rehsd/PC-65816/README.md

# PC-65816
PC based on 65816 microprocessor, now running at 14 MHz

Repository for schematics, PCB designs, assembly code, etc. for 65816-based motherboard and related peripherals. All schematic/PCB archives are from EasyEDA.

https://www.rehsdonline.com/blog/categories/65816-1
