rehsd/PC-65816/Schematics and PCB Design Files/Motherboard 1.2/Address Decode PLD/Read Me.txt

*.dig (software: Digital) -- see https://github.com/hneemann/Digital

*.png -- overview of the address decode logic I am using

*.jed -- compiled file to be burned to PLD, based on .png and .dig above

How to: https://www.rehsdonline.com/post/using-gal22v10-programmable-logic-devices
