rehsd/PC-65816/Schematics and PCB Design Files/Motherboard 1.2/Address Decode PLD/Addressing Worksheet.png

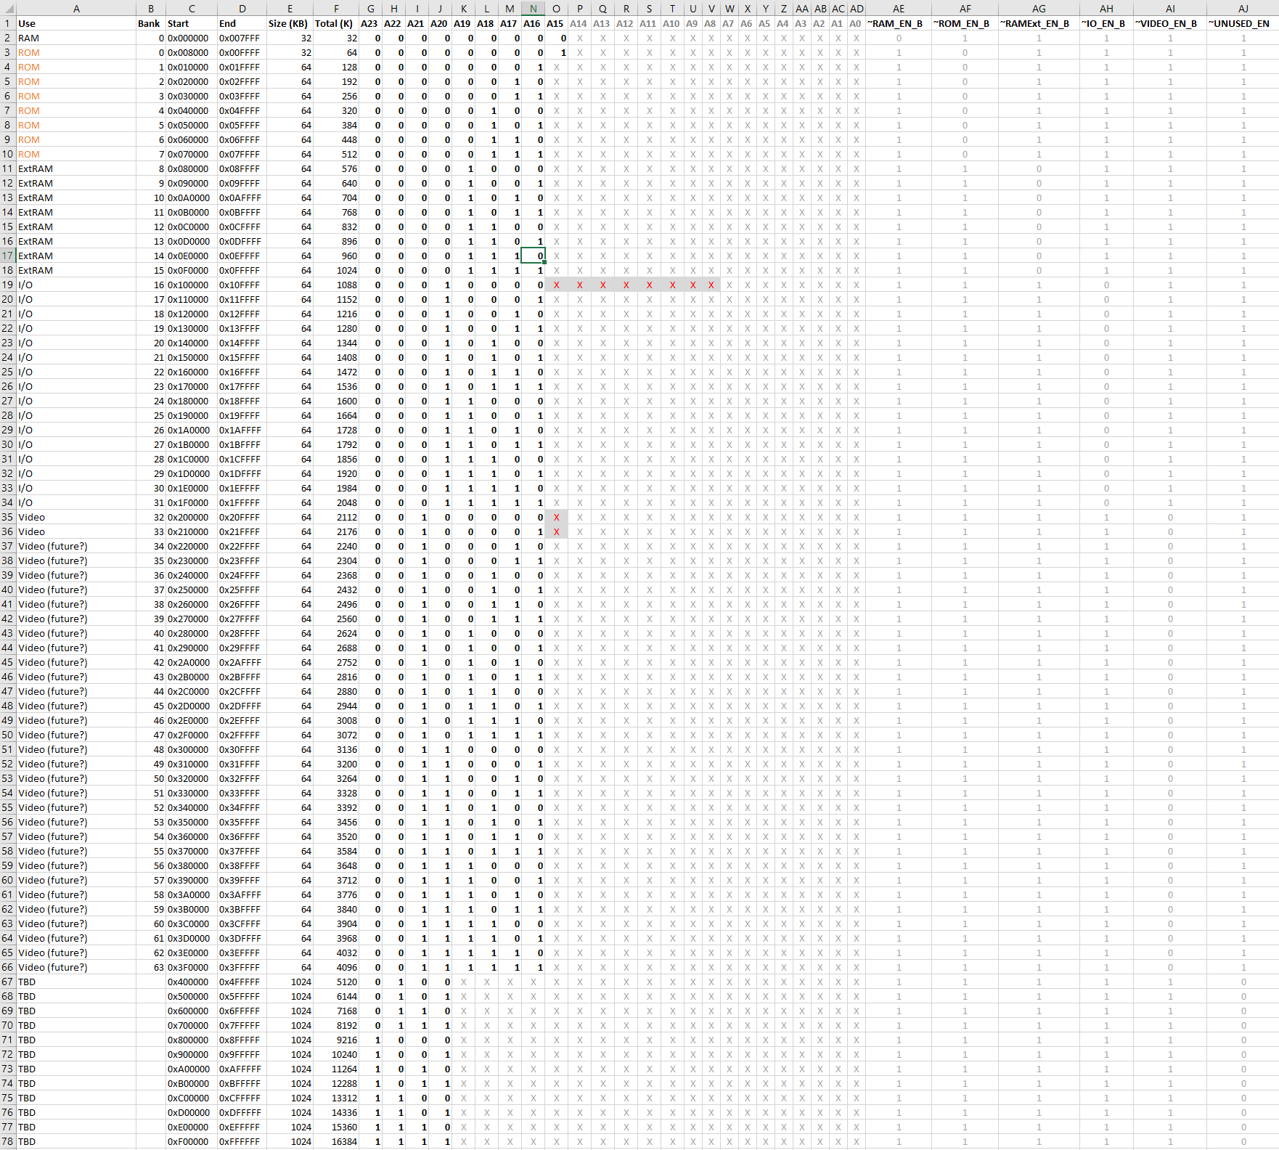
Schematics and PCB Design Files/Motherboard 1.2/Address Decode PLD/Addressing Worksheet.png
