rehsd/PC-65816/Schematics and PCB Design Files/Motherboard 1.2/Address Decode PLD/Logic in Digital.png

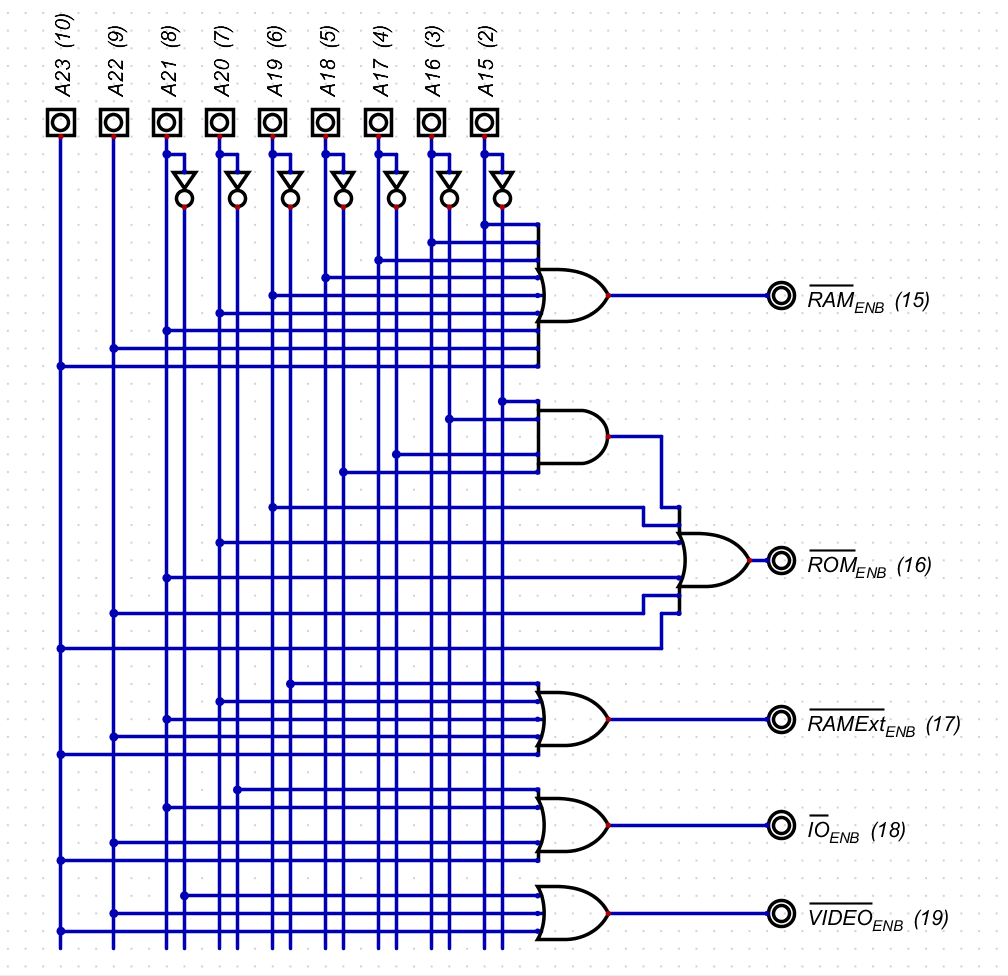
Schematics and PCB Design Files/Motherboard 1.2/Address Decode PLD/Logic in Digital.png
