rehsd/PC-65816/Schematics and PCB Design Files/Motherboard 1.2/mb 1.2 back.png

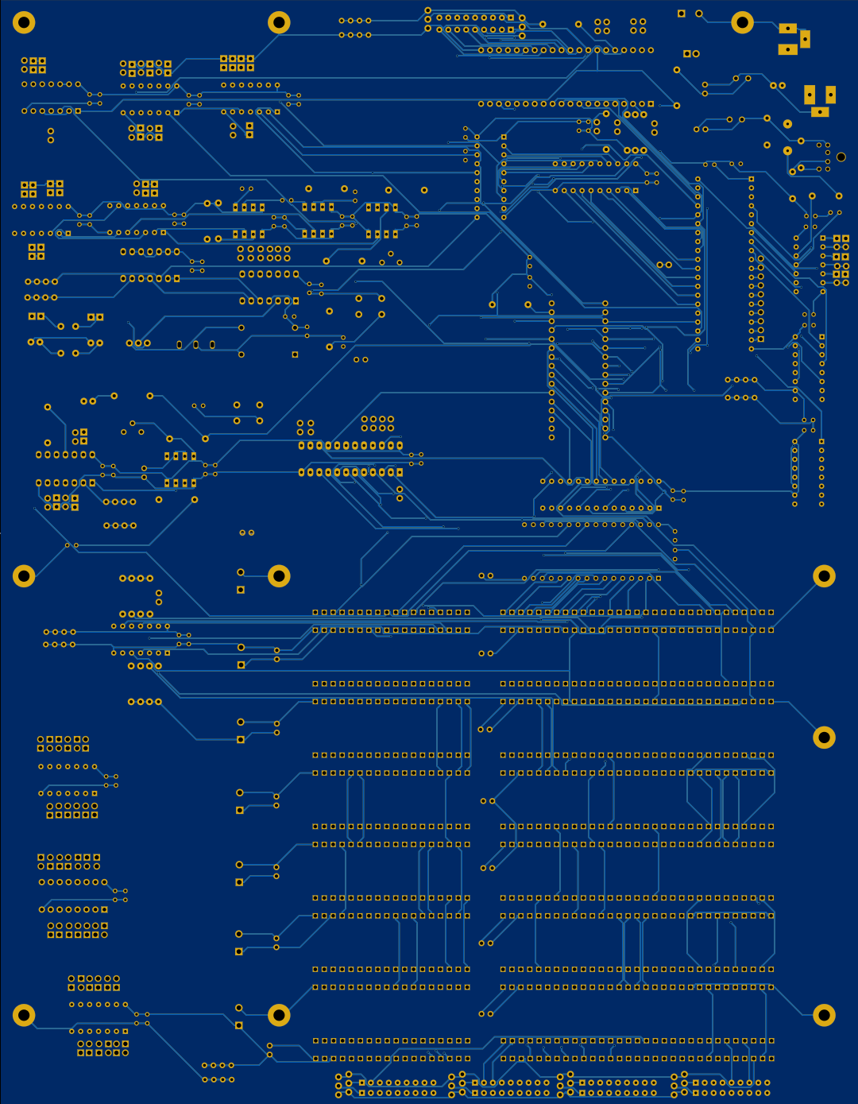
Schematics and PCB Design Files/Motherboard 1.2/mb 1.2 back.png
