rehsd/PC-65816/Schematics and PCB Design Files/Sound Card 1.1/Sound Card 65816 version 1.1 PCB.png

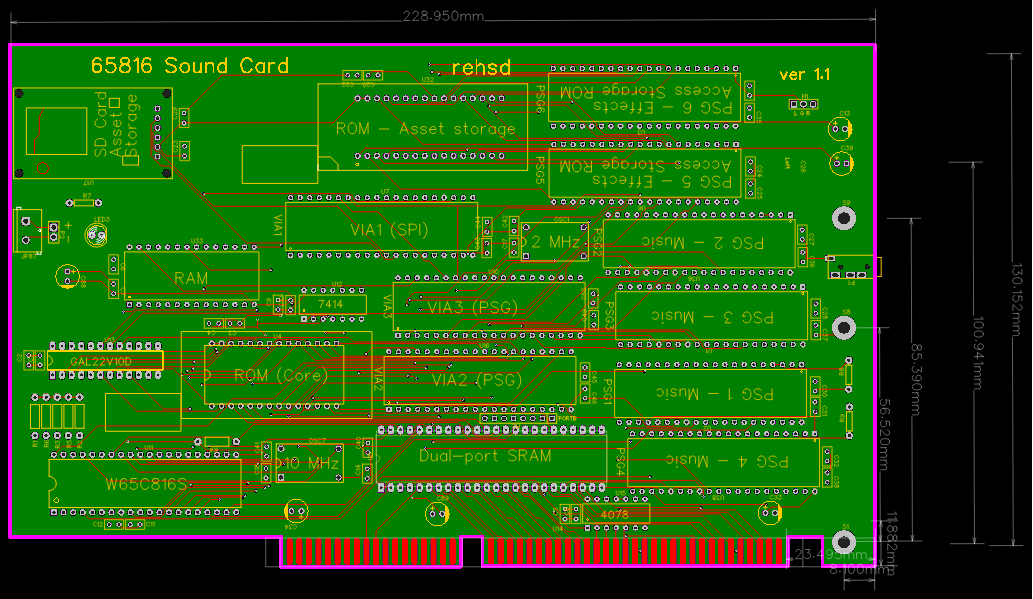
Schematics and PCB Design Files/Sound Card 1.1/Sound Card 65816 version 1.1 PCB.png
