rehsd/PC-65816/Schematics and PCB Design Files/Sound Card 1.1/Sound Card 65816 version 1.1b SCHEMATIC.pdf

# 256Kx8 RAM Audio Core

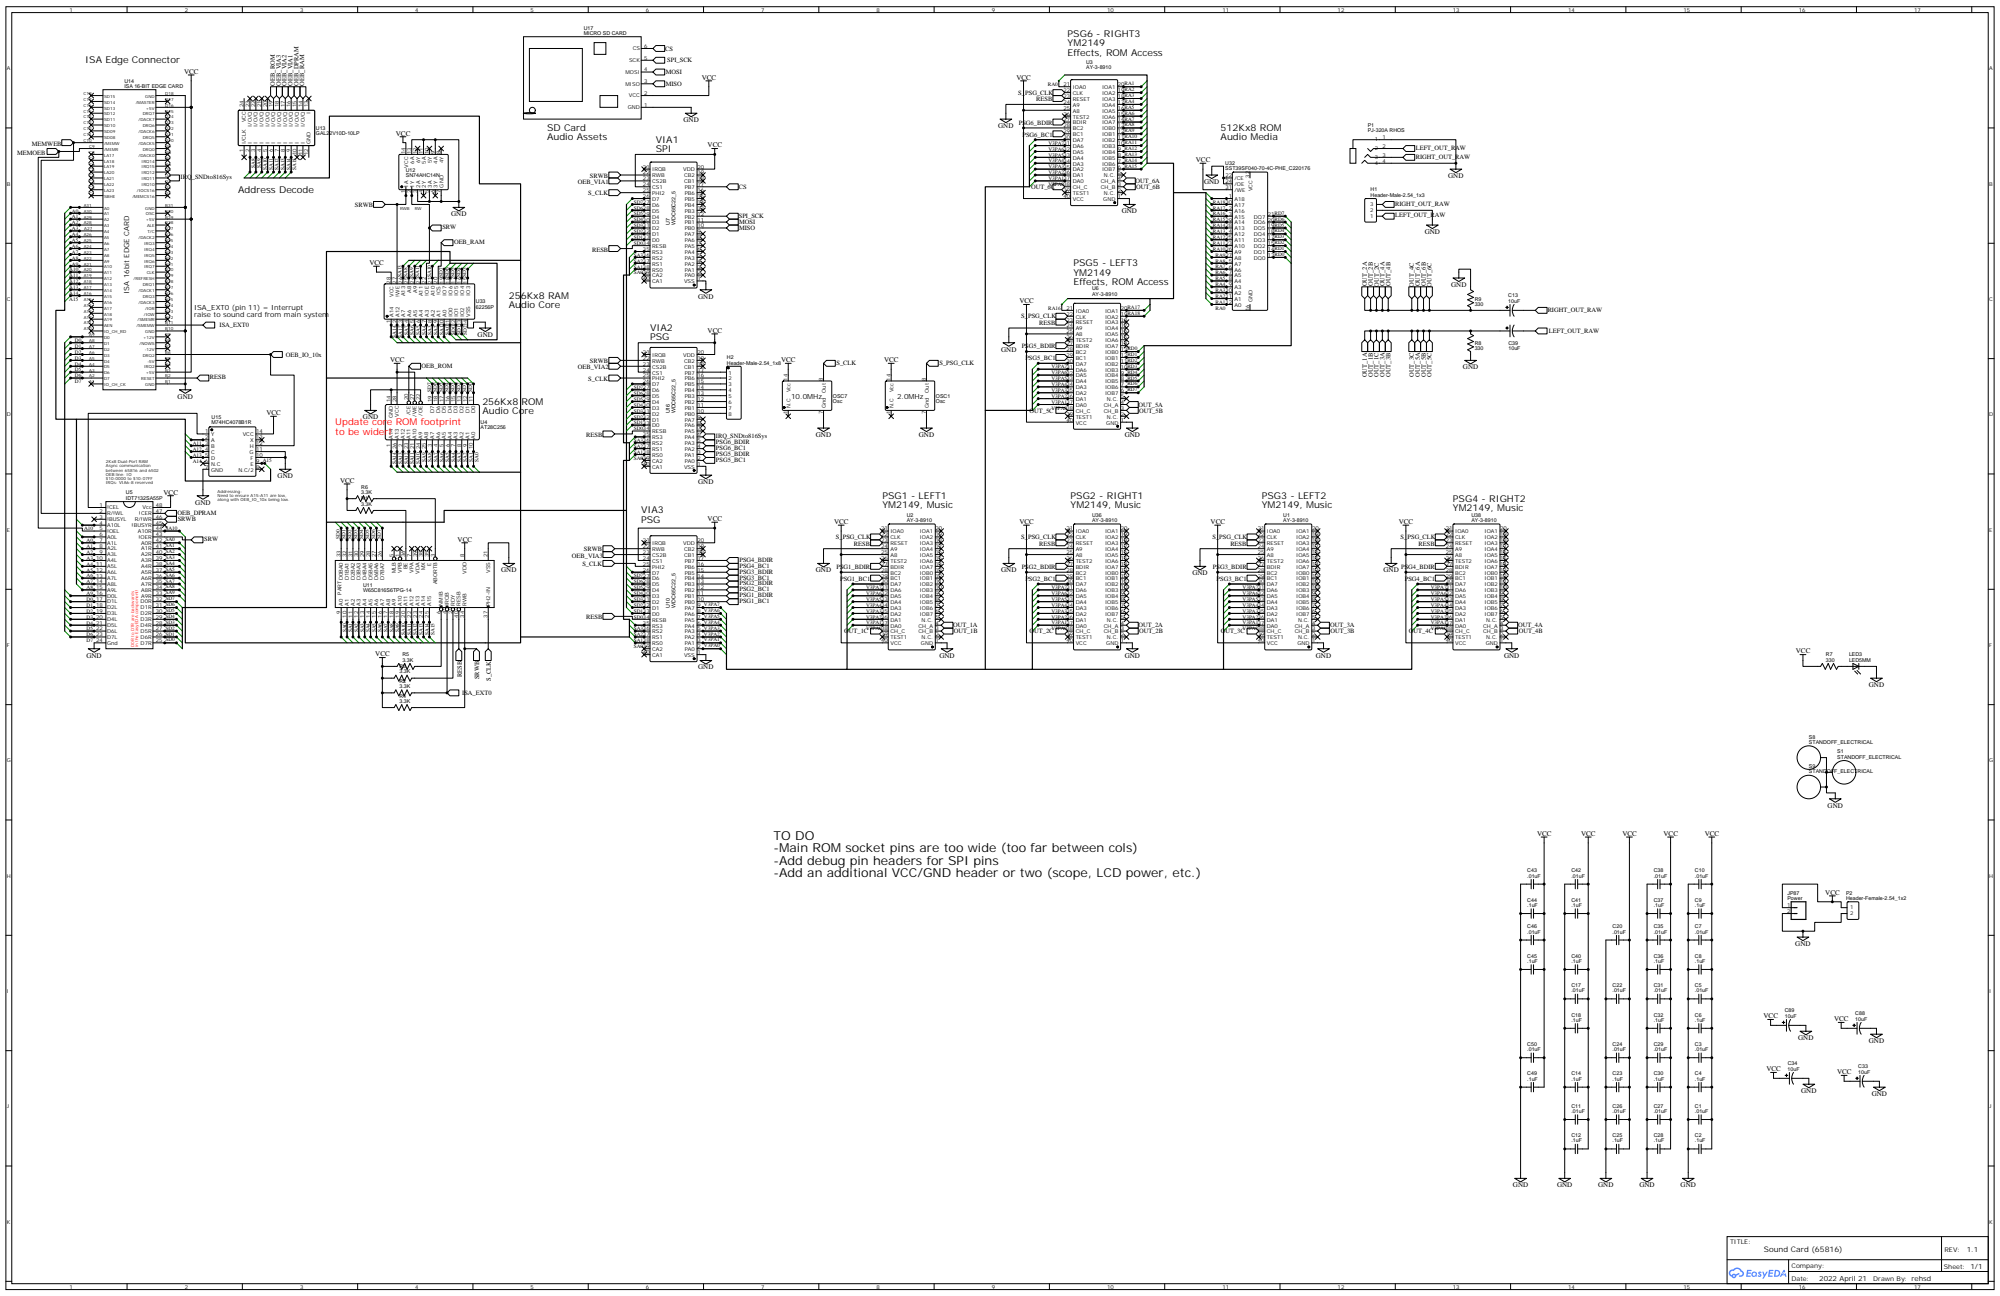
[picture p6: page 1]

ISA 16-BIT EDGE CARD

VSS 14 IO3 15 IO4 16 IO5 17 IO6 18 IO7 19 !CS 20 A10 21 !OE 22 A11 23 A9 24 A8 25 A13 26 !WE 27 VCC 28

ISA_EXT0 (pin 11) = Interrupt
raise to sound card from main system

GND
Update core ROM footprint
to be wider!

in the EasyEDA component!

-Main ROM socket pins are too wide (too far between cols)
-Add debug pin headers for SPI pins
-Add an additional VCC/GND header or two (scope, LCD power, etc.)
