rehsd/PC-65816/Schematics and PCB Design Files/Motherboard 1.2/Schematic_65816 Motherboard 1.0_2022-05-04.pdf

## RAM

32Kx8

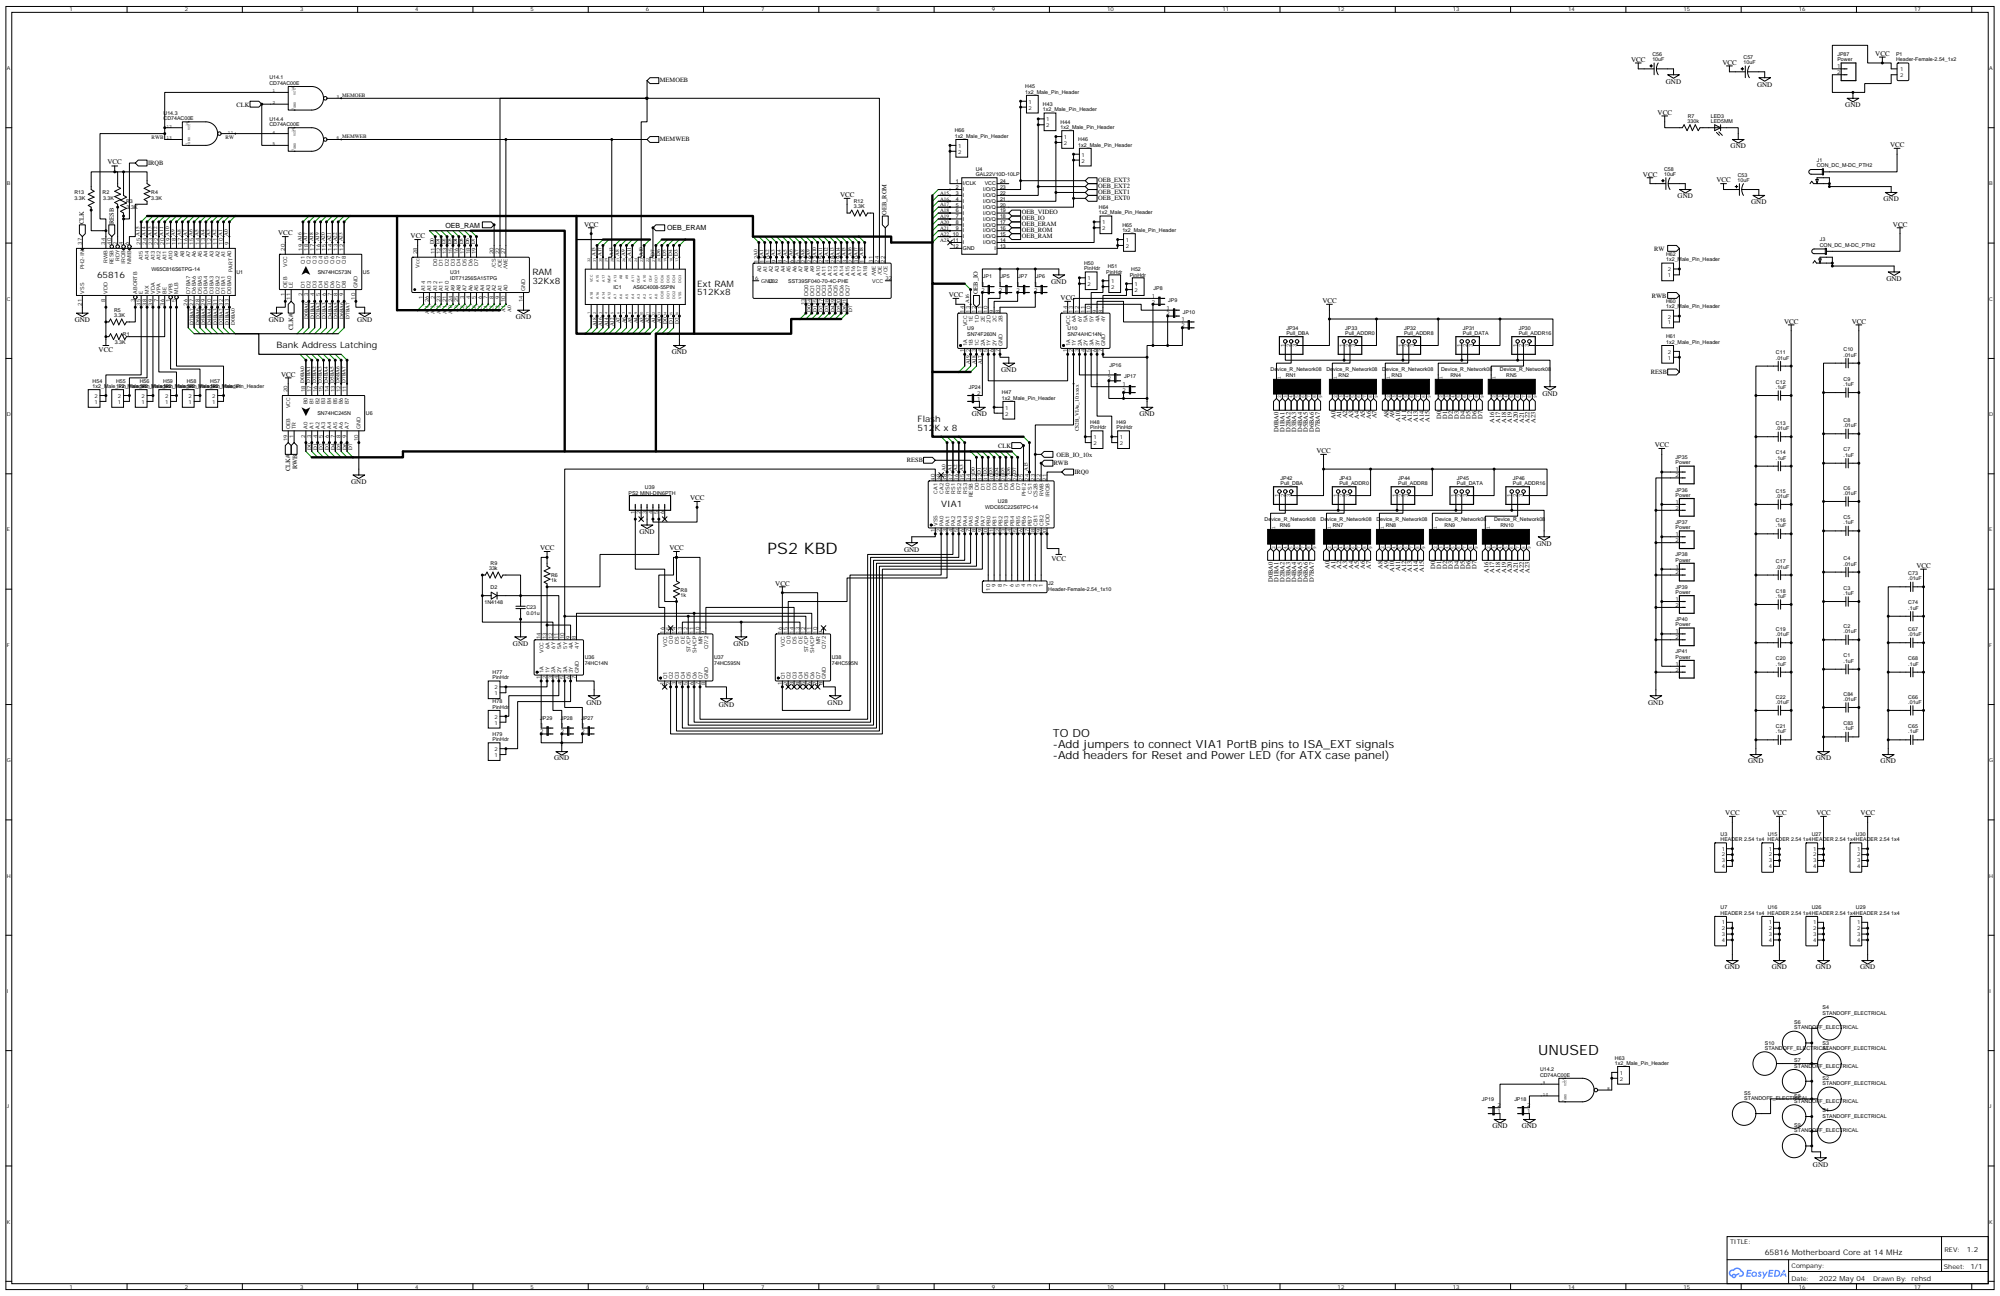
[picture p7: page 1]

VIA1 A⁰ A¹ A² A³

VDD 20 IRQB 21 RWB 22 CS2B 23 CS1 24 PHI2 25 D7 26 D6 27 D5 28 D4 29 D3 30 D2 31 D1 32 D0 33 RESB 34 RS3 35 RS2 36 RS1 37 RS0 38 CA2 39 CA1 40

9 MR 10 SH/CP 11 ST/CP 12 OE 13 DS 14 Q0 15 VCC 16

-Add jumpers to connect VIA1 PortB pins to ISA_EXT signals
-Add headers for Reset and Power LED (for ATX case panel)

65816 Motherboard Core at 14 MHz

## Reset

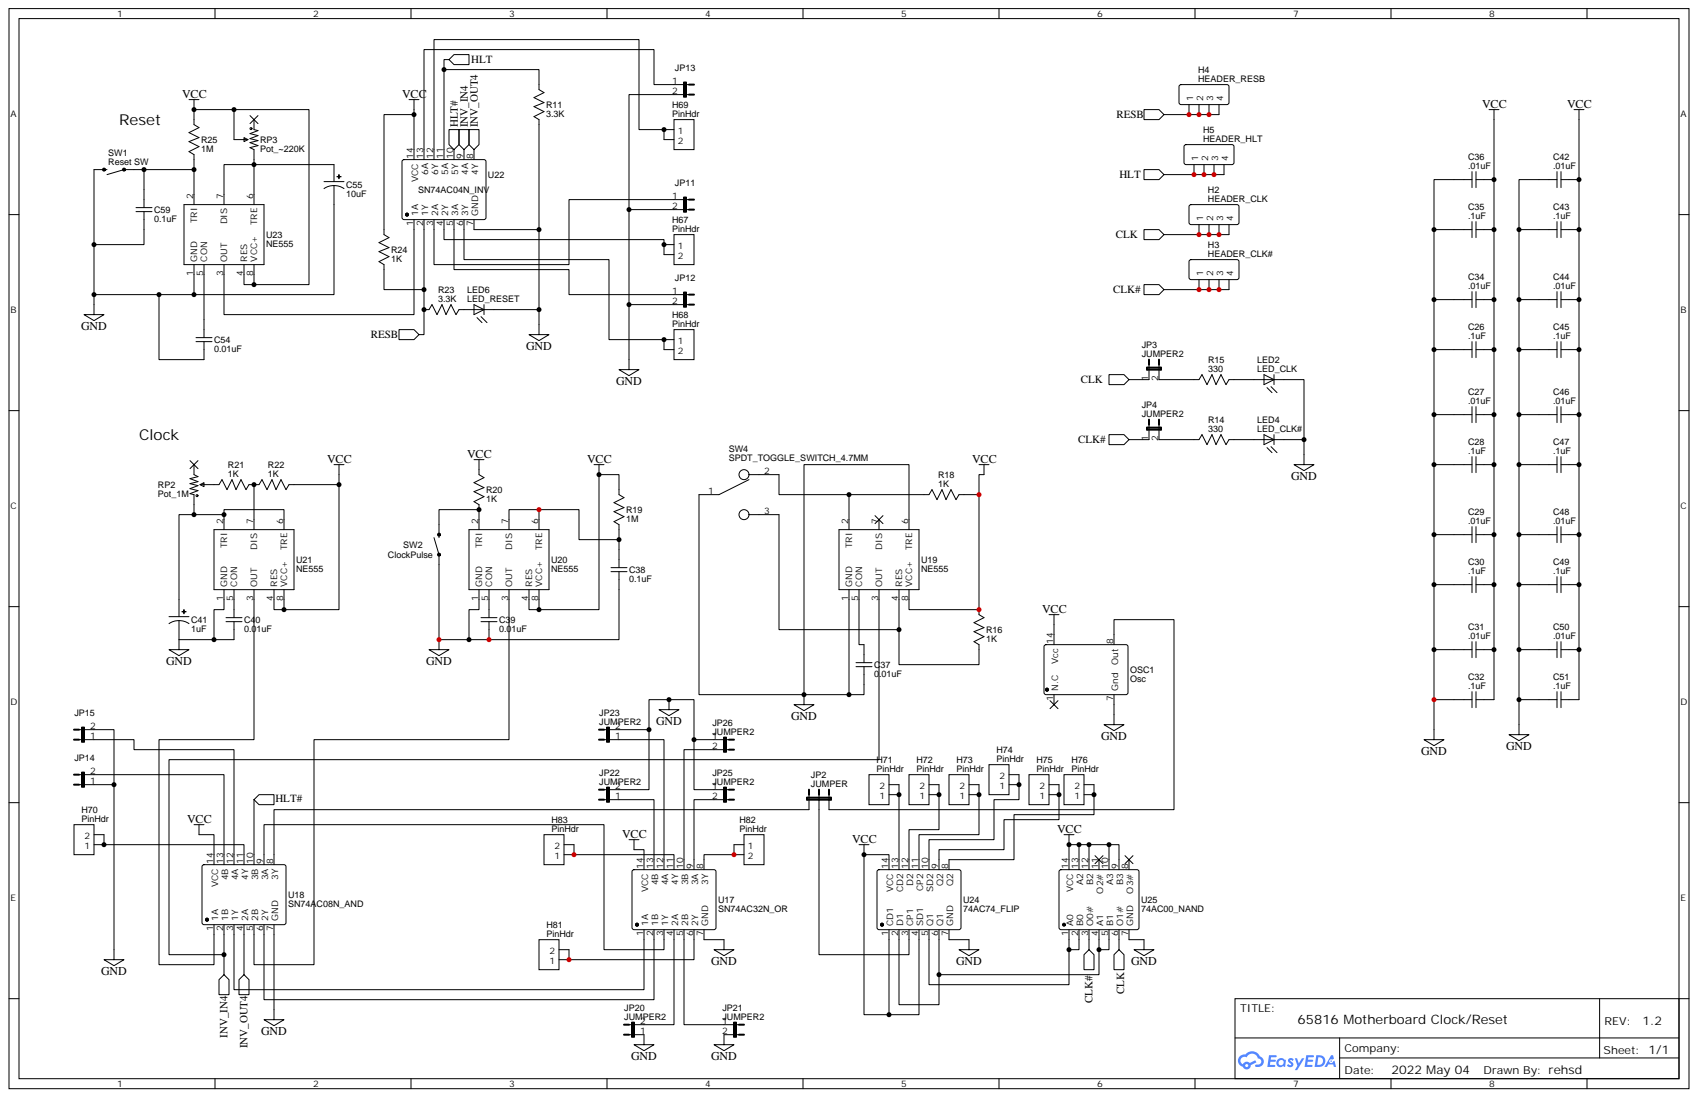
[picture p8: page 2]

GND 10 SMEMW 11 SMEMR 12 IOW 13 IOR 14 DACK3 15 DRQ3 16 DACK1 17 DRQ1 18 REFRESH 19 CLK 20 IRQ5 21 IRQ4 22 IRQ3 23 IRQ2 24 IRQ1 25 DACK2 26 TC 27 ALE 28 +5V 29 CLK# 30 GND 31
IOCHK 50 DB7 51 DB6 52 DB5 53 DB4 54 DB3 55 DB2 56 DB1 57 DB0 58 IORDY 59 AEN 60 BA19 61 BA18 62 BA17 63 BA16 64 BA15 65 BA14 66 BA13 67 BA12 68 BA11 69 BA10 70 BA9 71 BA8 72 BA7 73 BA6 74 BA5 75 BA4 76 BA3 77

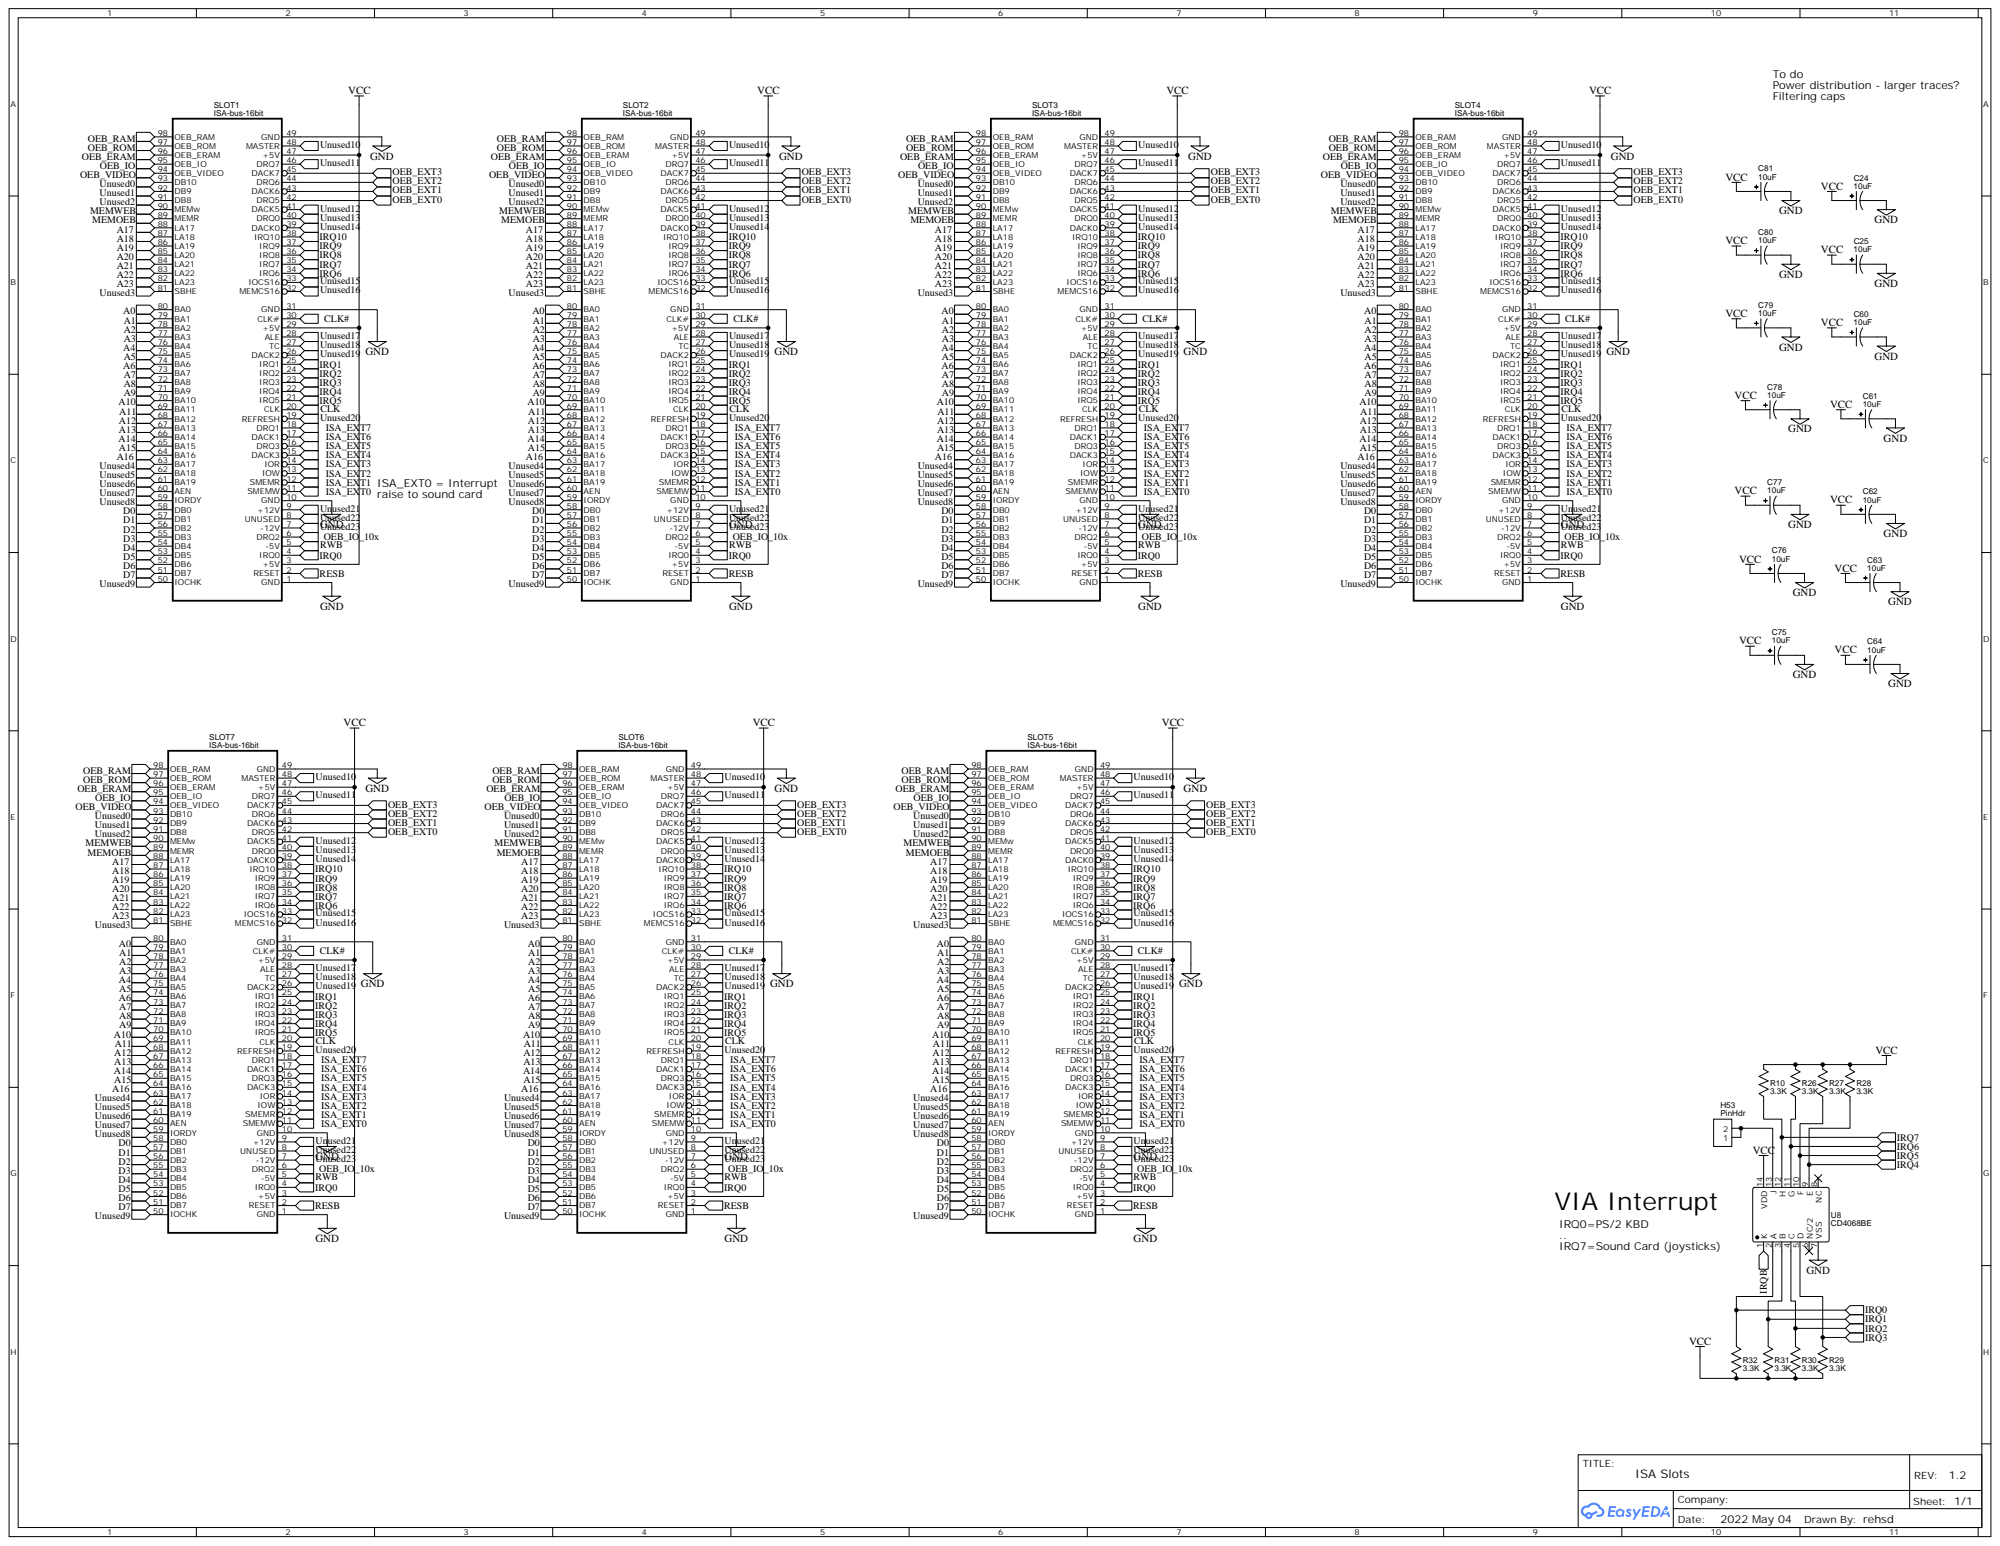
[picture p9: page 3]

Power distribution - larger traces?
Filtering caps

ISA_EXT0 = Interrupt
raise to sound card

## General Logic ICs

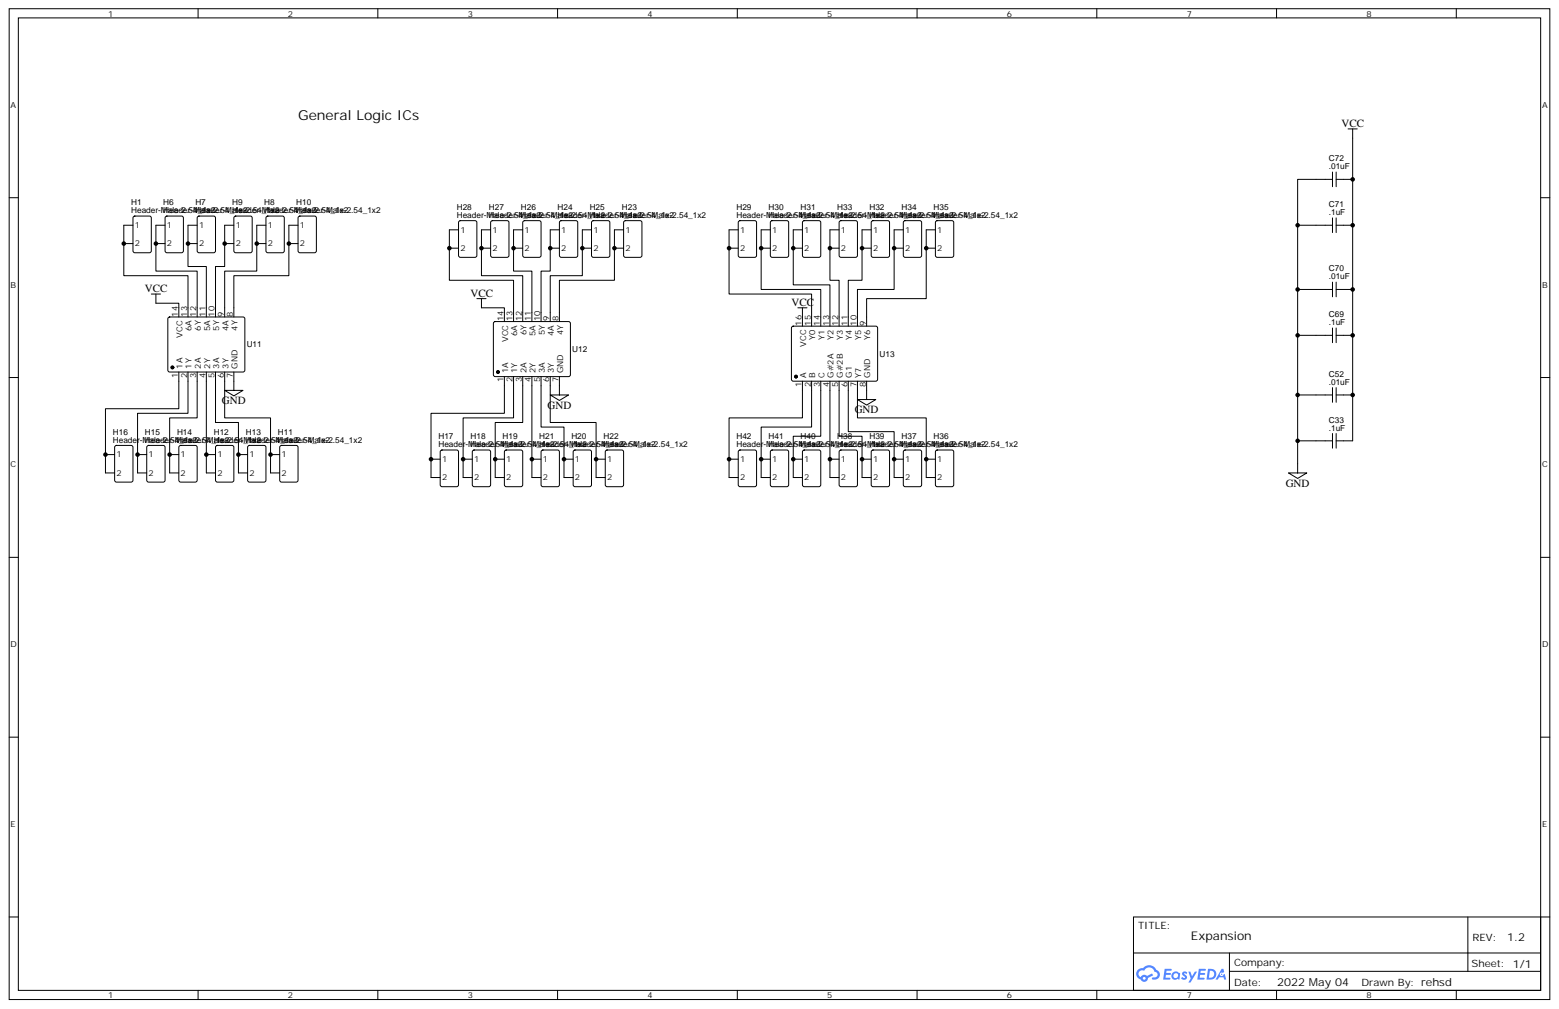
[picture p10: page 4]
