rehsd/PC-65816/Schematics and PCB Design Files/Updated Designs/Schematic_65816 ISA LCD_2022-04-19.pdf

A | A

1

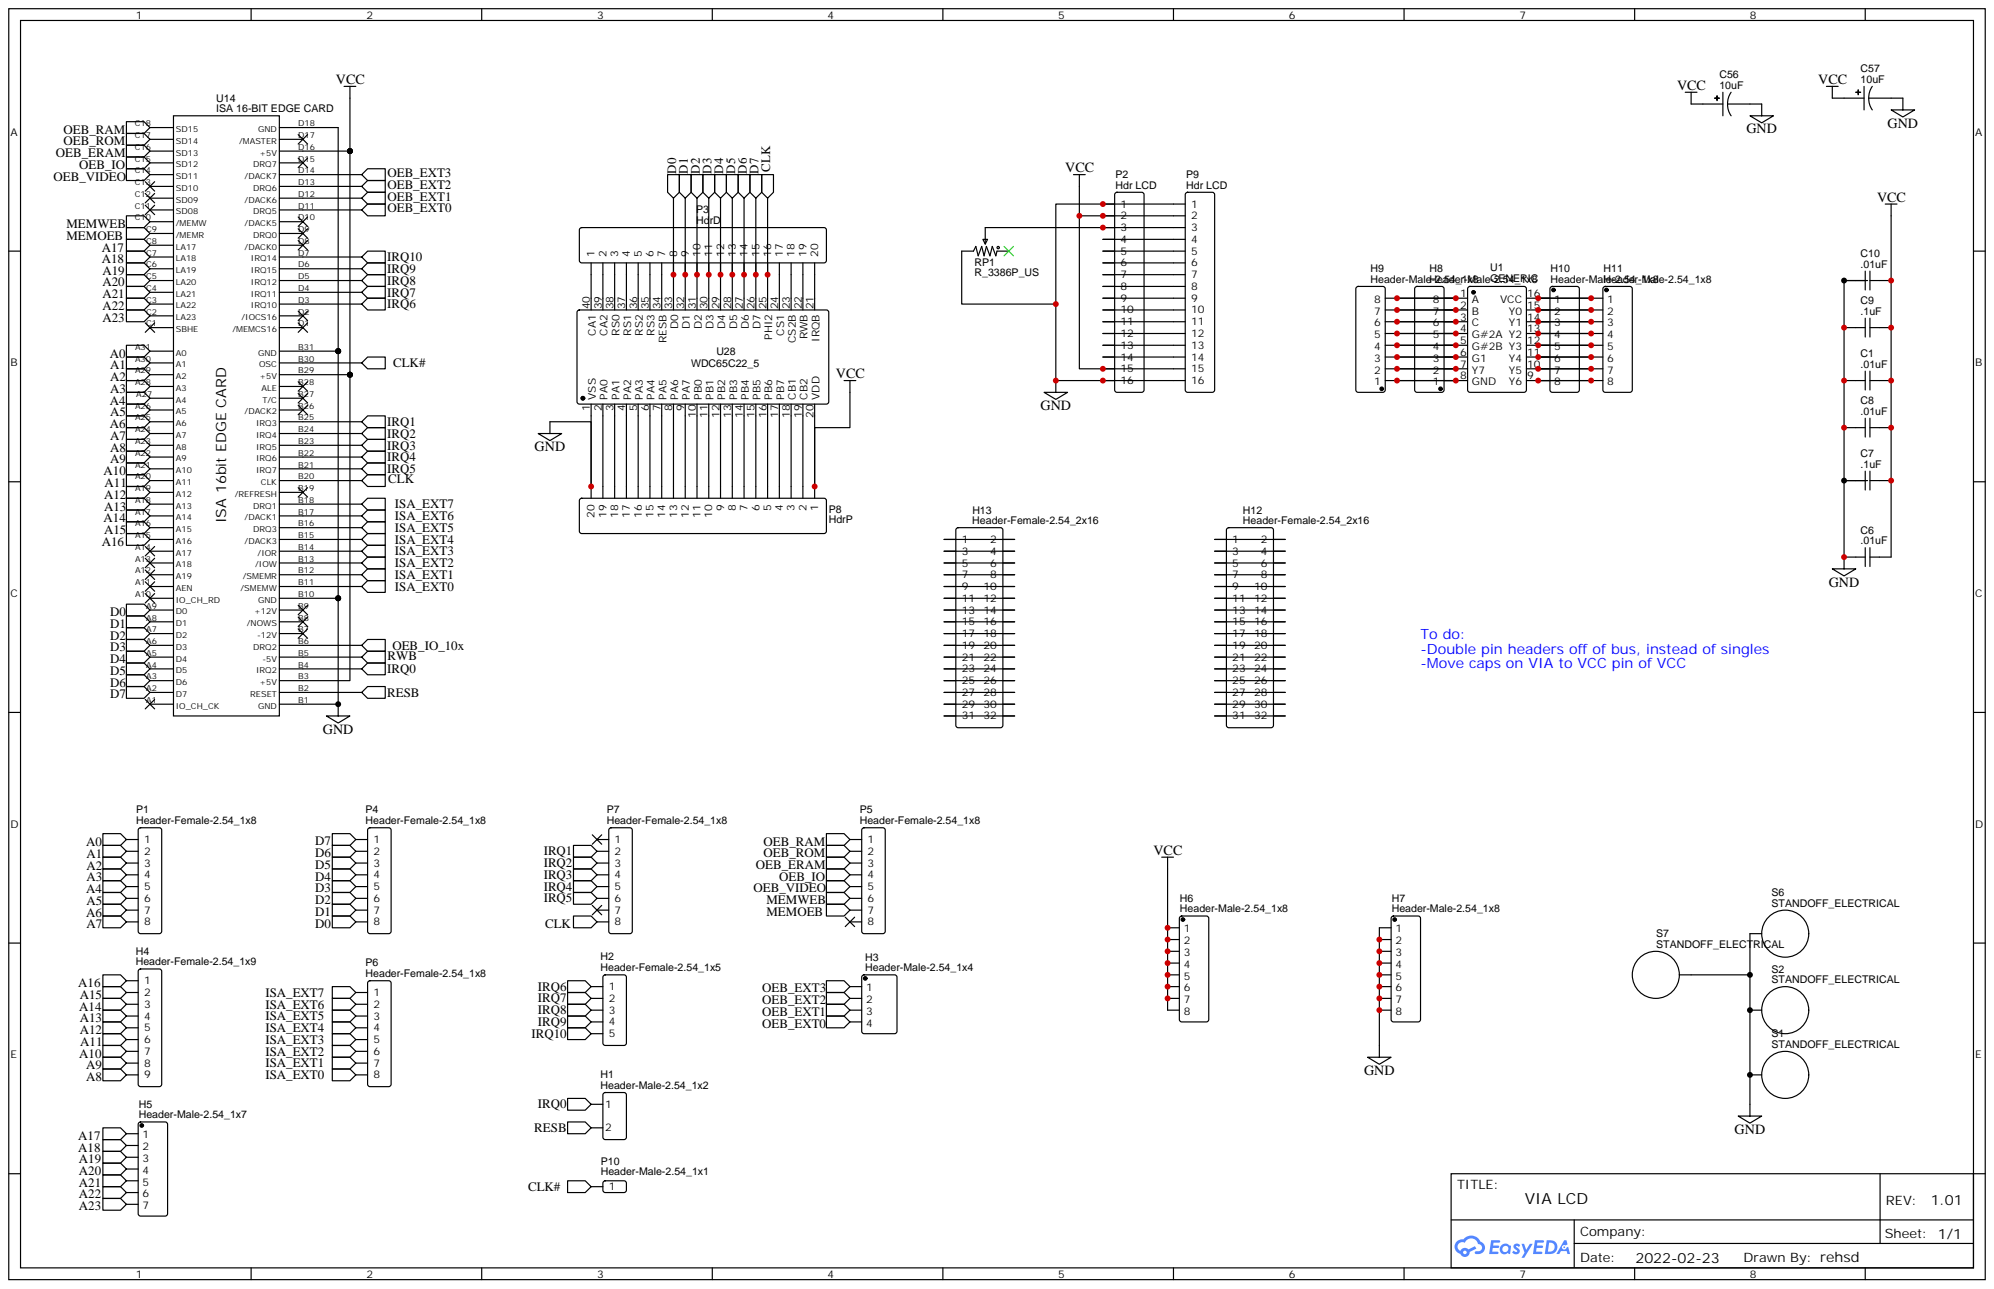
[picture p11: page 1]

ISA 16-BIT EDGE CARD

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

-Double pin headers off of bus, instead of singles

OEB_IO_10x
-Move caps on VIA to VCC pin of VCC RWB
IRQ0
RESB
