rehsd/PC-65816/Assembly Code/July 9 2022/graphics.asm

;Tiles:     0x0C0000-0x0DFFFF (Extended RAM)
;Sprites:   0x0E0000-0x0FFFFF (Extended RAM)
;VRAM:      0x200000-0x21FFFF

.setting "HandleLongBranch", true
.setting "RegA16", true
.setting "RegXY16", true

video_init:

  video_init_skipTestPattern:

  //lda #%00100100      ;RGB value for transparent pixel
  //jsr gfx_FillScreenSPRITES
  lda #$00  ;done processing pre-defined strings
  sta message_to_process

  // lda #%11100000   ;red
  // //sta pixel_prev_color
  // jsr gfx_FillScreenTILES

  // lda #200
  // sta gfx_tile_start_y
  // lda #190
  // sta gfx_tile_start_x
  // jsr gfx_CopyTileToVRAM

  ;jsr gfx_BackgroundDynamic
  lda #$24    //transparent equiv.
  jsr gfx_FillScreenTILES
  jsr gfx_DrawStartButton
  jsr gfx_Render_Full_Page

  ;Mario

    lda #$0800
    sta gfx_ROM_source_address
    lda #$0000
    sta gfx_ERAM_dest_address  
    jsr gfx_CacheSprite_16x16

    lda #$0900      ;increment by x100 (256)
    sta gfx_ROM_source_address
    lda #$0010      ;increment by x010 (16)
    sta gfx_ERAM_dest_address  
    jsr gfx_CacheSprite_16x16

    lda #$0A00
    sta gfx_ROM_source_address
    lda #$0020
    sta gfx_ERAM_dest_address  
    jsr gfx_CacheSprite_16x16
  
    lda #$0B00
    sta gfx_ROM_source_address
    lda #$0030
    sta gfx_ERAM_dest_address  
    jsr gfx_CacheSprite_16x16

    lda #$0C00      ;increment by x100 (256)
    sta gfx_ROM_source_address
    lda #$0040      ;increment by x010 (16)
    sta gfx_ERAM_dest_address  
    jsr gfx_CacheSprite_16x16

    lda #$0D00
    sta gfx_ROM_source_address
    lda #$0050
    sta gfx_ERAM_dest_address  
    jsr gfx_CacheSprite_16x16

    lda #$0E00
    sta gfx_ROM_source_address
    lda #$0060
    sta gfx_ERAM_dest_address  
    jsr gfx_CacheSprite_16x16

    lda #$0F00      ;increment by x100 (256)
    sta gfx_ROM_source_address
    lda #$0070      ;increment by x010 (16)
    sta gfx_ERAM_dest_address  
    jsr gfx_CacheSprite_16x16

    lda #$1000
    sta gfx_ROM_source_address
    lda #$0080
    sta gfx_ERAM_dest_address  
    jsr gfx_CacheSprite_16x16
  
    lda #$1100
    sta gfx_ROM_source_address
    lda #$0090
    sta gfx_ERAM_dest_address  
    jsr gfx_CacheSprite_16x16

    lda #$1200      ;increment by x100 (256)
    sta gfx_ROM_source_address
    lda #$00A0      ;increment by x010 (16)
    sta gfx_ERAM_dest_address  
    jsr gfx_CacheSprite_16x16

    lda #$1300
    sta gfx_ROM_source_address
    lda #$00B0
    sta gfx_ERAM_dest_address  
    jsr gfx_CacheSprite_16x16


  ;Set location for new chars from keyboard
  lda #0
  sta char_y_offset
  lda #4
  sta char_vp_x    ;0 to 319
  lda #4
  sta char_vp_y    ;0 to 239
  jsr gfx_SetCharVpByXY_TILES

  lda #$FF
  sta char_color
  
  rts
gfx_Render_Full_Page:
  pha
  phx
  phy
  ;copy frame buffer to video RAM
  ;x = source addr, y = dest addr, a = length-1
  ;mvn destBank, sourceBank
  ldx #$0000
  ldy #$0000
  lda #$FFFF
  phb

  //TO DO Combine with sprite layer

  ;Copying entire C0000 and D0000 to VRAM
  ;TO DO Is it faster to MVN only the actively-used portion of C/D0000?
  mvn $20, $0C    ;20 is top half of video frame, 0E is the first half of the frame buffer in extended RAM
  mvn $21, $0D    ;21 is bottom half of video frame, 0F is the second half of the frame buffer in extended RAM

  plb
  ply
  plx
  pla

  rts
gfx_DrawStartButton:

  ;bar
  lda #0
  sta fill_region_start_x
  lda #226
  sta fill_region_start_y
  lda #319
  sta fill_region_end_x
  lda #239
  sta fill_region_end_y
  lda #%10010010
  sta fill_region_color
  jsr gfx_FillRegionTILES

  ;button
  lda #7
  sta fill_region_start_x
  lda #226
  sta fill_region_start_y
  lda #41
  sta fill_region_end_x
  lda #239
  sta fill_region_end_y
  lda #%11011011
  sta fill_region_color
  jsr gfx_FillRegionTILES

  ;button corner
  lda #7
  sta fill_region_start_x
  lda #226
  sta fill_region_start_y
  lda #8
  sta fill_region_end_x
  lda #227
  sta fill_region_end_y
  lda #%10010010
  sta fill_region_color
  jsr gfx_FillRegionTILES

  ;button corner
  lda #40
  sta fill_region_start_x
  lda #226
  sta fill_region_start_y
  lda #41
  sta fill_region_end_x
  lda #227
  sta fill_region_end_y
  lda #%10010010
  sta fill_region_color
  jsr gfx_FillRegionTILES

  ;button corner
  lda #7
  sta fill_region_start_x
  lda #238
  sta fill_region_start_y
  lda #8
  sta fill_region_end_x
  lda #239
  sta fill_region_end_y
  lda #%10010010
  sta fill_region_color
  jsr gfx_FillRegionTILES

  ;button corner
  lda #40
  sta fill_region_start_x
  lda #238
  sta fill_region_start_y
  lda #41
  sta fill_region_end_x
  lda #239
  sta fill_region_end_y
  lda #%10010010
  sta fill_region_color
  jsr gfx_FillRegionTILES

  ;button text
  lda #4
  sta char_y_offset
  lda #6
  sta char_vp_x    ;0 to 319
  lda #230
  sta char_vp_y    ;0 to 239
  jsr gfx_SetCharVpByXY_TILES
  lda #%00100101
  sta char_color
  lda #$53  ;'S'  
  jsr print_char_vga
  lda #$54  ;'T'  
  jsr print_char_vga
  lda #$41  ;'A'  
  jsr print_char_vga
  lda #$52  ;'R'  
  jsr print_char_vga
  lda #$54  ;'T'  
  jsr print_char_vga

  rts
gfx_DrawStartMenu
  ;remember previous pixel location before drawing
  lda fill_region_start_x
  sta pixel_prev_x
  lda fill_region_start_y
  sta pixel_prev_y

  ;start menu box (contains menu choices)
  lda #5
  sta fill_region_start_x
  lda #160
  sta fill_region_start_y
  lda #60
  sta fill_region_end_x
  lda #224
  sta fill_region_end_y
  lda #%01001010
  sta fill_region_color
  jsr gfx_FillRegionTILES
  jsr gfx_FillRegionVRAM

  ;button text
  lda #0
  sta char_y_offset
  lda #8
  sta char_vp_x    ;0 to 319
  lda #165
  sta char_vp_y    ;0 to 239
  jsr gfx_SetCharVpByXY_TILES
  lda #%11111111
  sta char_color
  lda #$4E  ;'N'  
  jsr print_char_vga
  lda #$4F  ;'O'  
  jsr print_char_vga
  lda #$54  ;'T'  
  jsr print_char_vga
  lda #$45  ;'E'  
  jsr print_char_vga
  lda #$53  ;'S'  
  jsr print_char_vga

  lda #0
  sta char_y_offset
  lda #8
  sta char_vp_x    ;0 to 319
  lda #175
  sta char_vp_y    ;0 to 239
  jsr gfx_SetCharVpByXY_TILES
  lda #%11111111
  sta char_color
  lda #$50  ;'P'  
  jsr print_char_vga
  lda #$41  ;'A'  
  jsr print_char_vga
  lda #$49  ;'I'  
  jsr print_char_vga
  lda #$4E  ;'N'  
  jsr print_char_vga
  lda #$54  ;'T'  
  jsr print_char_vga

  lda #0
  sta char_y_offset
  lda #8
  sta char_vp_x    ;0 to 319
  lda #185
  sta char_vp_y    ;0 to 239
  jsr gfx_SetCharVpByXY_TILES
  lda #%11111111
  sta char_color
  lda #$47  ;'G'  
  jsr print_char_vga
  lda #$41  ;'A'  
  jsr print_char_vga
  lda #$4D  ;'M'  
  jsr print_char_vga
  lda #$45  ;'E'  
  jsr print_char_vga
  lda #$53  ;'S'  
  jsr print_char_vga

  lda #0
  sta char_y_offset
  lda #8
  sta char_vp_x    ;0 to 319
  lda #195
  sta char_vp_y    ;0 to 239
  jsr gfx_SetCharVpByXY_TILES
  lda #%11111111
  sta char_color
  lda #$56  ;'V'  
  jsr print_char_vga
  lda #$49  ;'I'  
  jsr print_char_vga
  lda #$41  ;'A'  
  jsr print_char_vga
  lda #$20  ;' '  
  jsr print_char_vga
  lda #$54  ;'T'  
  jsr print_char_vga
  lda #$45  ;'E'  
  jsr print_char_vga
  lda #$53  ;'S'  
  jsr print_char_vga
  lda #$54  ;'T'  
  jsr print_char_vga

  lda #0
  sta char_y_offset
  lda #8
  sta char_vp_x    ;0 to 319
  lda #205
  sta char_vp_y    ;0 to 239
  jsr gfx_SetCharVpByXY_TILES
  lda #%11111111
  sta char_color
  lda #'M'
  jsr print_char_vga
  lda #'U'
  jsr print_char_vga
  lda #'S'
  jsr print_char_vga
  lda #'I'
  jsr print_char_vga
  lda #'C'
  jsr print_char_vga

  lda #01
  sta StartButtonVisible
  jsr gfx_ResetMouseCursor  //keep the mouse white

  lda #15
  sta fill_region_start_x
  lda #230
  sta fill_region_start_y
  lda #%11111111  ;white
  sta fill_region_color
  lda #%00100101
  sta pixel_prev_color
  lda #0
  sta currently_drawing
  jsr gfx_DrawPixelTILES

  ;restore previous location
  lda pixel_prev_x
  sta fill_region_start_x
  lda pixel_prev_y
  sta fill_region_start_y

  rts
gfx_ResetMouseCursor:
  lda #$FF
  sta fill_region_color
  rts
gfx_FillScreenVRAM:
    //a = fill color
  sta color
  pha ;a to stack
  phx ;x to stack
  phy ;y to stack

  //set vidpage back to start
  lda #$0020
  sta vidpageVRAM + 2
  lda #$0000
  sta vidpageVRAM
  
  ldy #$00                ;start counter - pixels in row
  ldx #$00                ;row number

  _gfx_fillscreenvram_loop:
    ;draw a line
    lda color           
    ;sta [vidpage], y                                                                        ;8031
    jsr WriteVidPageVRAM
    iny     
    tya
    cmp #320        ;rollover        ;stop at 320 pixels in the row
    bne _gfx_fillscreenvram_loop                                                                          ;8038

    ;next row...
    clc
    lda vidpageVRAM                                                                             ;803D
    adc #512    ;skip pixels 320 to 511, go to next row                                     ;803F
    sta vidpageVRAM                                                                             ;8042
    ldy #0
    inx
    txa
    cmp #128    ;once 128 rows are processed, increment vidpage+2 to go to the next page
    bne _gfx_fillscreenvram_loop
    sta row
    ldx #0
    ldy #0
    clc
    lda vidpageVRAM+2
    adc #$0001
    sta vidpageVRAM+2   
    cmp #$22        ;20-21 are valid for video, 22 is next I/O range, so done with video
    bne _gfx_fillscreenvram_loop


  ply ;stack to y
  plx ;stack to x
  pla ;stack to a
  rts
gfx_FillRegionVRAM:
  ;inputs: fill_region_start_x, fill_region_start_y, fill_region_end_x, fill_region_end_y, fill_region_color
  pha ;a to stack
  phx ;x to stack
  phy ;y to stack
  
  ;store current 'cursor' location
  lda vidpageVRAM + 2
  sta vidpagePrevVRAM + 2
  lda vidpageVRAM
  sta vidpagePrevVRAM
  gfx_FillRegionVRAMLoopStart:
    ;start location
    lda fill_region_start_y
    sta jump_to_line_y

    jsr gfx_JumpToLineVRAM

    ldx fill_region_end_x
    inx
    ;stx $53 ; column# end comparison
    stx col_end ; column# end comparison
    
    lda fill_region_end_y
    sec
    sbc fill_region_start_y
    sta rows_remain ; rows remaining
    inc rows_remain ; add one to get count of rows to process

    gfx_FillRegionVRAMLoopYloop:
        ldy fill_region_start_x     ;horizontal pixel location, 0 to 319
        lda fill_region_color
            
        gfx_FillRegionVRAMLoopXloop:
            jsr WriteVidPageVRAM
            iny
            cpy col_end
            beq gfx_FRVLX_done    ;done with this row
            jmp gfx_FillRegionVRAMLoopXloop
        gfx_FRVLX_done:
            ;move on to next row
            dec rows_remain
            beq gfx_FRVLY_done
            lda vidpageVRAM
            clc
            adc #512
            sta vidpageVRAM    
            lda vidpageVRAM + 2   ;do not clc... need the carry bit to roll to the second (high) byte
            adc #$00          ;add carry
            sta vidpageVRAM + 2                  
            jmp gfx_FillRegionVRAMLoopYloop
        gfx_FRVLY_done:
        
    ;put things back and return to sender
    lda vidpagePrevVRAM+2
    sta vidpageVRAM + 2
    lda vidpagePrevVRAM
    sta vidpageVRAM

    ply ;stack to y
    plx ;stack to x
    pla ;stack to a
    rts
gfx_FillScreenTILES:
    //a = fill color
  sta color
  pha ;a to stack
  phx ;x to stack
  phy ;y to stack

  //set vidpage back to start
  lda #$000C
  sta vidpageTILES + 2
  lda #$0000
  sta vidpageTILES
  
  ldy #$00                ;start counter - pixels in row
  ldx #$00                ;row number

  _gfx_fillscreentiles_loop:
    ;draw a line
    lda color           
    ;sta [vidpage], y                                                                        ;8031
    jsr WriteVidPageTILES
    iny     
    tya
    cmp #320        ;rollover        ;stop at 320 pixels in the row
    bne _gfx_fillscreentiles_loop                                                                          ;8038

    ;next row...
    clc
    lda vidpageTILES                                                                             ;803D
    adc #512    ;skip pixels 320 to 511, go to next row                                     ;803F
    sta vidpageTILES                                                                             ;8042
    ldy #0
    inx
    txa
    cmp #128    ;once 128 rows are processed, increment vidpage+2 to go to the next page
    bne _gfx_fillscreentiles_loop
    sta row
    ldx #0
    ldy #0
    clc
    lda vidpageTILES+2
    adc #$0001
    sta vidpageTILES+2   
    cmp #$0E        ;0C-0D are valid for video, 22 is next I/O range, so done with video
    bne _gfx_fillscreentiles_loop


  ply ;stack to y
  plx ;stack to x
  pla ;stack to a
  rts
gfx_FillRegionTILES:
  ;inputs: fill_region_start_x, fill_region_start_y, fill_region_end_x, fill_region_end_y, fill_region_color
  pha ;a to stack
  phx ;x to stack
  phy ;y to stack
  
  ;store current 'cursor' location
  lda vidpageTILES + 2
  sta vidpagePrevTILES + 2
  lda vidpageTILES
  sta vidpagePrevTILES
  gfx_FillRegionTilesLoopStart:
    ;start location
    lda fill_region_start_y
    sta jump_to_line_y

    jsr gfx_JumpToLineTILES

    ldx fill_region_end_x
    inx
    ;stx $53 ; column# end comparison
    stx col_end ; column# end comparison
    
    lda fill_region_end_y
    sec
    sbc fill_region_start_y
    sta rows_remain ; rows remaining
    inc rows_remain ; add one to get count of rows to process

    gfx_FillRegionTilesLoopYloop:
        ldy fill_region_start_x     ;horizontal pixel location, 0 to 319
        lda fill_region_color
            
        gfx_FillRegionTilesLoopXloop:
            jsr WriteVidPageTILES
            iny
            cpy col_end
            beq gfx_FRTLX_done    ;done with this row
            jmp gfx_FillRegionTilesLoopXloop
        gfx_FRTLX_done:
            ;move on to next row
            dec rows_remain
            beq gfx_FRTLY_done
            lda vidpageTILES
            clc
            adc #512
            sta vidpageTILES    
            lda vidpageTILES + 2   ;do not clc... need the carry bit to roll to the second (high) byte
            adc #$00          ;add carry
            sta vidpageTILES + 2                  
            jmp gfx_FillRegionTilesLoopYloop
        gfx_FRTLY_done:
        
    ;put things back and return to sender
    lda vidpagePrevTILES+2
    sta vidpageTILES + 2
    lda vidpagePrevTILES
    sta vidpageTILES

    ply ;stack to y
    plx ;stack to x
    pla ;stack to a
    rts
gfx_JumpToLineTILES:
    pha
    phx
    phy

    ;set vidpage back to start
    lda #$000C
    sta vidpageTILES + 2
    lda #$0000
    sta vidpageTILES

    ldx jump_to_line_y
    ;if jump_to_line_y is 0, we are done
    cpx #$00
    ;TO DO Verify jump_to_line_y does not exceed 239
    beq gfx_JumpToLineTilesDone

    gfx_JumpToLineTilesLoop:
    jsr gfx_NextVGALineTILES     ;there has to be a better way that to call this loop -- more of a direct calculation -- TBD
    dex
    bne gfx_JumpToLineTilesLoop
    
    gfx_JumpToLineTilesDone:

    ply
    plx
    pla
    rts
gfx_NextVGALineTILES:
    pha
    ;move the location for writing to the screen down one line
    clc
    lda vidpageTILES
    adc #512         ;add 512 to move to next row
    sta vidpageTILES    
    lda vidpageTILES + 2   ;do not clc... need the carry bit to roll to the second (high) byte
    adc #$00          ;add carry
    sta vidpageTILES + 2
    pla
    rts
gfx_FillRegion_FrameBuffer:
  ;inputs: fill_region_start_x, fill_region_start_y, fill_region_end_x, fill_region_end_y, fill_region_color
  pha ;a to stack
  phx ;x to stack
  phy ;y to stack
  
  ;store current 'cursor' location
  lda vidpage_buffer + 2
  sta vidpagePrev_buffer + 2
  lda vidpage_buffer
  sta vidpagePrev_buffer
  gfx_FillRegionLoopStart_fb:
    ;start location
    lda fill_region_start_y
    sta jump_to_line_y

    jsr gfx_JumpToLine_FrameBuffer

    ldx fill_region_end_x
    inx
    stx col_end ; column# end comparison
    
    lda fill_region_end_y
    sec
    sbc fill_region_start_y
    sta rows_remain ; rows remaining
    inc rows_remain ; add one to get count of rows to process

    gfx_FillRegionLoopYloop_fb:
        ldy fill_region_start_x     ;horizontal pixel location, 0 to 319
        lda fill_region_color
            
        gfx_FillRegionLoopXloop_fb:
            ;sta [vidpage_buffer], y; write A register (color) to address vidpage + y
            jsr WriteVidPageBuffer
            iny
            cpy col_end
            beq gfx_FRLX_done_fb    ;done with this row
            jmp gfx_FillRegionLoopXloop_fb
        gfx_FRLX_done_fb:
            ;move on to next row
            dec rows_remain
            beq gfx_FRLY_done_fb
            lda vidpage_buffer
            clc
            adc #512
            sta vidpage_buffer    
            lda vidpage_buffer + 2   ;do not clc... need the carry bit to roll to the second (high) byte
            adc #$00          ;add carry
            sta vidpage_buffer + 2                  
            jmp gfx_FillRegionLoopYloop_fb
        gfx_FRLY_done_fb:
        
    ;put things back and return to sender
    lda vidpagePrev_buffer+2
    sta vidpage_buffer + 2
    lda vidpagePrev_buffer
    sta vidpage_buffer

    ply ;stack to y
    plx ;stack to x
    pla ;stack to a
    rts
gfx_JumpToLineVRAM:
    pha
    phx
    phy

    ;set vidpage back to start
    lda #$0020
    sta vidpageVRAM + 2
    lda #$0000
    sta vidpageVRAM

    ldx jump_to_line_y
    ;if jump_to_line_y is 0, we are done
    cpx #$0000
    beq gfx_JumpToLineVRAMDone

    ;Verify jump_to_line_y does not exceed 239
    cpx #$00EF    ;239
    bpl setToZero   ;probably should set to 239, but using 0 to make it more obvious if this is encountered (something else would need to be fixed)
    bra gfx_JumpToLineVRAMLoop
    
    setToZero:
      stz jump_to_line_y
      ldx jump_to_line_y
      bra gfx_JumpToLineVRAMDone

    gfx_JumpToLineVRAMLoop:
    jsr gfx_NextVGALineVRAM     ;there has to be a better way that to call this loop -- more of a direct calculation -- TBD
    dex
    bne gfx_JumpToLineVRAMLoop
    
    gfx_JumpToLineVRAMDone:

    ply
    plx
    pla
    rts
gfx_JumpToLine_FrameBuffer:
    pha
    phx
    phy

    ;set vidpage back to start
    lda #$000E
    sta vidpage_buffer + 2
    lda #$0000
    sta vidpage_buffer

    ldx jump_to_line_y
    ;if jump_to_line_y is 0, we are done
    cpx #$00
    ;TO DO Verify jump_to_line_y does not exceed 239
    beq gfx_JumpToLineDone_fb

    gfx_JumpToLineLoop_fb:
    jsr gfx_NextVGALine_FrameBufffer     ;there has to be a better way that to call this loop -- more of a direct calculation -- TBD
    dex
    bne gfx_JumpToLineLoop_fb
    
    gfx_JumpToLineDone_fb:

    ply
    plx
    pla
    rts
gfx_NextVGALineVRAM:
    pha
    ;move the location for writing to the screen down one line
    clc
    lda vidpageVRAM
    adc #512         ;add 512 to move to next row
    sta vidpageVRAM    
    lda vidpageVRAM + 2   ;do not clc... need the carry bit to roll to the second (high) byte
    adc #$00          ;add carry
    sta vidpageVRAM + 2
    pla
    rts
gfx_CRLF:
    pha
    ;move the location for writing to the screen down one line
    clc
    lda char_vp
    adc #5120         ;add 512 to move to next row (pixel)
    sta char_vp    
    lda char_vp + 2   ;do not clc... need the carry bit to roll to the second (high) byte
    adc #0          ;add carry
    sta char_vp + 2

    lda #$00
    sta char_y_offset

    pla
    rts
gfx_NextVGALine_FrameBufffer:
    pha
    ;move the location for writing to the screen down one line
    clc
    lda vidpage_buffer
    adc #512         ;add 512 to move to next row
    sta vidpage_buffer    
    lda vidpage_buffer + 2   ;do not clc... need the carry bit to roll to the second (high) byte
    adc #$00          ;add carry
    sta vidpage_buffer + 2
    pla
    rts
gfx_TestPattern:
  pha
  phx
  phy
  ;draw screen frame
    ;top bar
    lda #0
    sta fill_region_start_x
    lda #0
    sta fill_region_start_y
    lda #319
    sta fill_region_end_x
    lda #2
    sta fill_region_end_y
    lda #%11111111
    sta fill_region_color
    jsr gfx_FillRegionTILES

    ;bottom bar
    lda #0
    sta fill_region_start_x
    lda #237
    sta fill_region_start_y
    lda #319
    sta fill_region_end_x
    lda #239
    sta fill_region_end_y
    jsr gfx_FillRegionTILES

    ;left bar
    lda #0
    sta fill_region_start_x
    lda #3
    sta fill_region_start_y
    lda #2
    sta fill_region_end_x
    lda #236
    sta fill_region_end_y
    jsr gfx_FillRegionTILES

    ;right bar
    lda #317
    sta fill_region_start_x
    lda #3
    sta fill_region_start_y
    lda #319
    sta fill_region_end_x
    lda #236
    sta fill_region_end_y
    jsr gfx_FillRegionTILES

  ;draw red gradient
    lda #40
    sta fill_region_start_x
    lda #30
    sta fill_region_start_y
    lda #69
    sta fill_region_end_x
    lda #49
    sta fill_region_end_y
    lda #%00000000
    sta fill_region_color
    jsr gfx_FillRegionTILES
    
    lda #70
    sta fill_region_start_x
    lda #30
    sta fill_region_start_y
    lda #99
    sta fill_region_end_x
    lda #49
    sta fill_region_end_y
    lda #%00100000
    sta fill_region_color
    jsr gfx_FillRegionTILES

    lda #100
    sta fill_region_start_x
    lda #30
    sta fill_region_start_y
    lda #129
    sta fill_region_end_x
    lda #49
    sta fill_region_end_y
    lda #%01000000
    sta fill_region_color
    jsr gfx_FillRegionTILES

    lda #130
    sta fill_region_start_x
    lda #30
    sta fill_region_start_y
    lda #159
    sta fill_region_end_x
    lda #49
    sta fill_region_end_y
    lda #%01100000
    sta fill_region_color
    jsr gfx_FillRegionTILES

    lda #160
    sta fill_region_start_x
    lda #30
    sta fill_region_start_y
    lda #189
    sta fill_region_end_x
    lda #49
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
    lda #04
    sta message_to_process
    jsr PrintString

    lda #$00
    sta char_y_offset
    lda #120
    sta char_vp_x    ;0 to 319
    lda #171
    sta char_vp_y    ;0 to 239
    jsr gfx_SetCharVpByXY_TILES
    lda #05
    sta message_to_process
    jsr PrintString

    lda #$00
    sta char_y_offset
    lda #20
    sta char_vp_x    ;0 to 319
    lda #220
    sta char_vp_y    ;0 to 239
    jsr gfx_SetCharVpByXY_TILES
    lda #07
    sta message_to_process
    jsr PrintString
  skipLabels:

  
    // ;copy frame buffer to video RAM
    // ;x = source addr, y = dest addr, a = length-1
    // ;mvn destBank, sourceBank
    // ldx #$0000
    // ldy #$0000
    // lda #$FFFF
    // phb
    // mvn $20, $0E    ;21 is bottom half of video frame, 0F is the second half of the frame buffer in extended RAM
    // mvn $21, $0F    ;21 is bottom half of video frame, 0F is the second half of the frame buffer in extended RAM
    // plb

    jsr gfx_frameBufferToVideo
  ply
  plx
  pla
  rts
gfx_TextPattern_Animated_Ship_Background_Buffer:
  ;TO DO - break things into tiles and do this more efficiently
  pha
  phx
  phy

  // ;clear the drawing area   ;TO DO do this by tile -- only those tiles that need it - the following code is sloppy and for testing only
  // lda #10
  // sta fill_region_start_x
  // lda #183
  // sta fill_region_start_y
  // lda #315
  // sta fill_region_end_x
  // lda #215
  // sta fill_region_end_y
  // lda #%00000000
  // sta fill_region_color
  // jsr gfx_FillRegion

  lda #120
  sta fill_region_start_x
  lda #183
  sta fill_region_start_y
  lda #149
  sta fill_region_end_x
  lda #215
  sta fill_region_end_y
  lda #%11100000
  sta fill_region_color
  jsr gfx_FillRegion_FrameBuffer

  lda #150
  sta fill_region_start_x
  lda #179
  sta fill_region_end_x
  lda #%00011100
  sta fill_region_color
  jsr gfx_FillRegion_FrameBuffer

  lda #180
  sta fill_region_start_x
  lda #209
  sta fill_region_end_x
  lda #%00000011
  sta fill_region_color
  jsr gfx_FillRegion_FrameBuffer

  ply
  plx
  pla
  rts
gfx_TextPattern_Animated_Ship_Background:
  ;TO DO - break things into tiles and do this more efficiently
  pha
  phx
  phy

  lda #120
  sta fill_region_start_x
  lda #183
  sta fill_region_start_y
  lda #149
  sta fill_region_end_x
  lda #215
  sta fill_region_end_y
  lda #%11111100
  sta fill_region_color
  jsr gfx_FillRegionTILES

  lda #150
  sta fill_region_start_x
  lda #179
  sta fill_region_end_x
  lda #%00011111
  sta fill_region_color
  jsr gfx_FillRegionTILES

  lda #180
  sta fill_region_start_x
  lda #209
  sta fill_region_end_x
  lda #%11100011
  sta fill_region_color
  jsr gfx_FillRegionTILES

  ply
  plx
  pla
  rts
gfx_TestPattern_Animated_Ship:
  ;ship sprite stored on ROM at ;$020000 to $0203FF (with transparency)
  ;ship sprite stored on ROM at ;$020400 to $0207FF (without transparency)
  ;VGA is at $200000
  pha
  phx
  phy
  ;x = source addr, y = dest addr, a = length-1
  ;mvn destBank, sourceBank

  lda #0
  sta move_frame_counter
  lda #$7010  ;position at appropriate vertical position
  sta move_dest

  ship_frame_loop:
    lda #31    ;number of bytes per row
    sta move_size
    lda #$0400
    sta move_source
    lda #32   ;number of rows to process
    sta move_counter

    ship_line_loop:
      lda move_size     ;size (64 bytes)
      ldx move_source ;from
      ldy move_dest ;to
      phb
      mvn $21, $02    ;21 is bottom half of video frame, 02 is ROM page where this sprite is stored
      plb
      lda move_source
      clc
      adc #32
      sta move_source
      lda move_dest
      clc
      adc #512  ;next row
      sta move_dest
      dec move_counter
      bne ship_line_loop

    jsr delay
    inc move_frame_counter
    lda #$7010
    clc
    adc move_frame_counter
    sta move_dest
    lda move_frame_counter
    cmp #260
    bne ship_frame_loop

  ;clear the final ship
    lda #275
    sta fill_region_start_x
    lda #185
    sta fill_region_start_y
    lda #315
    sta fill_region_end_x
    lda #215
    sta fill_region_end_y
    lda #%00000000
    sta fill_region_color
    jsr gfx_FillRegionTILES

  ply
  plx
  pla
  rts
gfx_BackupBand:
  pha
  phx
  phy
  
  ;copy original band to ERAM
  ldx #$7010    ;starting position of band in vram
  ldy #$0000    ;startint position in eram to copy vram
  lda #$4000    ;32 rows of 512 wide
  phb
  mvn $0F, $21    ;21 is bottom half of video frame, 02 is ROM page where this sprite is stored -- copy from vram to eram
  plb

  ply
  plx
  pla
  rts
gfx_RestoreBandToBuffer:
  pha
  phx
  phy
  
  ;copy backup from ERAM to vram
  ldx #$0000    ;starting position of band in vram
  ldy #$0000    ;starting position in eram to copy vram
  lda #$4000    ;32 rows of 512 wide
  phb
  mvn $0D, $0F    ;21 is bottom half of video frame, 02 is ROM page where this sprite is stored -- copy from vram to eram
  plb

  ply
  plx
  pla
  rts
gfx_WriteBufferToVideo:
  pha
  phx
  phy
  
  // ;copy buffer to vram
  // ldx #$0000    ;starting position of band in eram
  // ldy #$7010    ;starting position in vram to copy
  // lda #$4000    ;32 rows of 512 wide
  // phb
  // mvn $21, $0D    ;21 is bottom half of video frame, 02 is ROM page where this sprite is stored -- copy from vram to eram
  // plb

  //only write out the part of the buffer where the sprite was recently moved
  //move_frame_counter then #512 per row
  // ldx move_frame_counter
  // lda #$FF
  // sta $7010, x    //spli $210000 & $7010 out

  //32 rows
  lda #32 ;rows to process
  sta move_counter_wb
  lda move_frame_counter
  sta move_source_wb
  lda #$7010
  clc
  adc move_frame_counter
  sta move_dest_wb

  anotherRow:
    lda move_size
    ldx move_source_wb
    ldy move_dest_wb

    phb
    mvn $21, $0D    ;21 is bottom half of video frame, 02 is ROM page where this sprite is stored -- copy from vram to eram
    plb

    lda move_source_wb
    clc
    adc #512
    sta move_source_wb
    lda move_dest_wb
    clc
    adc #512
    sta move_dest_wb
    dec move_counter_wb
    bne anotherRow

  ply
  plx
  pla
  rts
gfx_TestPattern_Animated_Ship_WithTransparency:
  ;ship sprite stored on ROM at ;$020000 to $0203FF (with transparency)
  ;ship sprite stored on ROM at ;$020400 to $0207FF (without transparency)
  ;VGA is at $200000
  pha
  phx
  phy
  ;x = source addr, y = dest addr, a = length-1
  ;mvn destBank, sourceBank

  jsr gfx_TextPattern_Animated_Ship_Background
  jsr gfx_BackupBand

  lda #0
  sta move_frame_counter
  sta move_dest

  ship_frame_loop_wt:
    jsr gfx_RestoreBandToBuffer
    lda #31    ;number of bytes per row
    sta move_size
    lda #$00
    sta move_source
    lda #32   ;number of rows to process
    sta move_counter

    ship_line_loop_wt:
      lda move_size   
      ldx move_source ;from
      ldy move_dest ;to
      phb
      ;mvn $21, $02    ;21 is bottom half of video frame, 02 is ROM page where this sprite is stored
      jsr mvn_withtransparency

      plb
      lda move_source
      clc
      adc #32
      sta move_source
      lda move_dest
      clc
      adc #512  ;next row
      sta move_dest
      dec move_counter
      bne ship_line_loop_wt

    
    jsr gfx_WriteBufferToVideo

    ;jsr delay
    inc move_frame_counter
    inc move_frame_counter
    lda #$0
    clc
    adc move_frame_counter
    sta move_dest
    lda move_frame_counter
    cmp #260
    bne ship_frame_loop_wt

  ;clear the final ship
    lda #275
    sta fill_region_start_x
    lda #185
    sta fill_region_start_y
    lda #315
    sta fill_region_end_x
    lda #215
    sta fill_region_end_y
    lda #%00000000
    sta fill_region_color
    jsr gfx_FillRegionTILES

  ply
  plx
  pla
  rts
mvn_withtransparency:
  ;pha 
  ;phx
  ;phy
  .setting "RegA16", false
  ;sep #$20            ;set acumulator to 8-bit

  ;x = source addr, y = dest addr, a = length-1
  ;sta mvn_wtransp_src_bank
  ;sta mvn_wtransp_dest_bank
  sta mvn_wtransp_length
  inc mvn_wtransp_length  //a = length -1; branch logic below checks for 0
  mvn_withtransparency_loop:
    lda $020000,x   ;load from ROM
    inx
    phx
    tyx
    and #$00FF  ;in 16-bit mode, pulling double-byte -- only want to look at the lsb
    cmp #%00100100    ;RGB value for transparent pixel
    beq skipPixel

    ;sta $0D0000, x    ;write to buffer
    sep #$20            ;set acumulator to 8-bit
    sta $0D0000, x    ;write to buffer
    rep #$20            ;set acumulator to 16-bit

    skipPixel:
    inx
    txy
    plx
    dec mvn_wtransp_length
    bne mvn_withtransparency_loop


  .setting "RegA16", true
  ;rep #$20            ;set acumulator to 16-bit
  ;ply
  ;plx
  ;pla
  rts
gfx_frameBufferToVideo:
  pha
  phx
  phy
  ;copy frame buffer to video RAM
  ;x = source addr, y = dest addr, a = length-1
  ;mvn destBank, sourceBank
  ldx #$0000
  ldy #$0000
  lda #$FFFF
  phb
  mvn $21, $0F    ;21 is bottom half of video frame, 0F is the second half of the frame buffer in extended RAM
  mvn $20, $0E    ;21 is bottom half of video frame, 0F is the second half of the frame buffer in extended RAM
  plb
  ply
  plx
  pla
  rts
gfx_StartScreen:
  ;top bar - red
  lda #0
  sta fill_region_start_x
  lda #0
  sta fill_region_start_y
  lda #319
  sta fill_region_end_x
  lda #2
  sta fill_region_end_y
  lda #%11100000
  sta fill_region_color
  jsr gfx_FillRegionTILES

  ;bottom bar - yellow
  lda #0
  sta fill_region_start_x
  lda #237
  sta fill_region_start_y
  lda #319
  sta fill_region_end_x
  lda #239
  sta fill_region_end_y
  lda #%11111100
  sta fill_region_color
  jsr gfx_FillRegionTILES

  ;left bar - green
  lda #0
  sta fill_region_start_x
  lda #3
  sta fill_region_start_y
  lda #2
  sta fill_region_end_x
  lda #236
  sta fill_region_end_y
  lda #%00011100
  sta fill_region_color
  jsr gfx_FillRegionTILES

  ;right bar - blue
  lda #317
  sta fill_region_start_x
  lda #3
  sta fill_region_start_y
  lda #319
  sta fill_region_end_x
  lda #236
  sta fill_region_end_y
  lda #%00000011
  sta fill_region_color
  jsr gfx_FillRegionTILES
  rts
gfx_SetCharVpByXY:
  ;TO DO safety code (keep in bounds)
  pha
  phx
  phy
  ;convert x,y position to char_vp and char_vp+2
  ;char_vp_x    0 to 319
  ;char_vp_y    0 to 239
  ;char_vp      512 bytes per row, max of 320 rows -- all zero-based
  
  ;reset to default location of 0020:0000, or pixel 9,0
  lda #$0020
  sta char_vp+2
  lda #$0000
  sta char_vp

  ;for each y, add 512
  ldy char_vp_y
  cpy #0    ;if 0, don't add for y, since top row
  beq addX_step
  y_loop:
    clc
    lda char_vp
    adc #512
    sta char_vp
    lda char_vp+2
    adc #0    ;no clc, to carry to next word
    sta char_vp+2
    dec char_vp_y
    bne y_loop

  ;add X
  addX_step:
    clc
    lda char_vp
    adc char_vp_x
    sta char_vp
    lda char_vp+2
    adc #0    ;no clc, to carry to next word
    sta char_vp + 2

  ply
  plx
  pla
  rts
gfx_SetCharVpByXY_TILES:
  ;TO DO safety code (keep in bounds)
  pha
  phx
  phy
  ;convert x,y position to char_vp and char_vp+2
  ;char_vp_x    0 to 319
  ;char_vp_y    0 to 239
  ;char_vp      512 bytes per row, max of 320 rows -- all zero-based
  
  ;reset to default location of 000C:0000, or pixel 9,0
  lda #$000C
  sta char_vp+2
  lda #$0000
  sta char_vp

  ;for each y, add 512
  ldy char_vp_y
  cpy #0    ;if 0, don't add for y, since top row
  beq addXt_step
  yt_loop:
    clc
    lda char_vp
    adc #512
    sta char_vp
    lda char_vp+2
    adc #0    ;no clc, to carry to next word
    sta char_vp+2
    dec char_vp_y
    bne yt_loop

  ;add X
  addXt_step:
    clc
    lda char_vp
    adc char_vp_x
    sta char_vp
    lda char_vp+2
    adc #0    ;no clc, to carry to next word
    sta char_vp + 2

  ply
  plx
  pla
  rts
print_char_vga:
  ; TO DO safety code... this function assumes a valid ascii char that is supported
  ;current char is in A(ccumulator)
  sta char_current_val
  lda char_vp+2
  sta vidpageTILES+2
  clc
  adc #$0014
  sta vidpageVRAM+2
  lda char_vp
  sta vidpageTILES
  sta vidpageVRAM
      
  ldy char_y_offset  ;column start
  //cpy #300    ;cols - past this will CRLF
  cpy #$012C    ;cols - past this will CRLF
  bcc pcv_cont
    jsr gfx_CRLF
  pcv_cont:
  sty char_y_offset_orig   ;remember this offset, so we can come back each row

  ldx #$00
  ;stx $52   ;character pixel row loop counter
  stx charPixelRowLoopCounter   ;character pixel row loop counter

  ; https://www.asc.ohio-state.edu/demarneffe.1/LING5050/material/ASCII-Table.png
  
  _nextRow:
    lda char_current_val
    sec
    sbc #$0020  ;translate from ASCII value to address in ROM   ;example: 'a' 0x61 minus 0x20 = 0x41 for location in charmap
    ;multiply by 8 (8 bits per byte)
    asl   ;double
    asl   ;double again
    asl   ;double a third time
    clc
    adc charPixelRowLoopCounter   ;for each loop through rows of pixel, increase this by one, so that following logic fetches the correct char pixel row
    clc
    ;adc #$07 ;advance to the next char
    tax
    lda charmap, x
    AND #$00FF      ; 16-bit adjustment to code
    sta char_from_charmap
    jmp CharMap_Selected
print_hex_vga:
    ;convert scancode/ascii value/other hex to individual chars and display
    ;e.g., scancode = #$12 (left shift) but want to show '0x12' on LCD
    ;accumulator has the value of the scancode

    ;put items on stack, so we can return them
    pha ;a to stack
    phx ;x to stack
    phy ;y to stack

    ;sta $65     ;store A so we can keep using original value
    sta tmpHex
    
    lda #$78    ;'x'
    jsr print_char_vga

    ;high nibble
    lda tmpHex
    and #%11110000
    lsr ;shift high nibble to low nibble
    lsr
    lsr
    lsr
    tay
    lda hexOutLookup, y
    and #$00FF    ;16-bit adjustment
    jsr print_char_vga

    ;low nibble
    lda tmpHex
    and #%00001111
    tay
    lda hexOutLookup, y
    and #$00FF    ;16-bit adjustment
    jsr print_char_vga

    ;return items from stack
    ply ;stack to y
    plx ;stack to x
    pla ;stack to a
    rts
CharMap_Selected:
    charpix_col1:
      ;lda $50   ;stored current char from appropriate charmap
      lda char_from_charmap   ;stored current char from appropriate charmap
      and #PIXEL_COL1   ;look at the first column of the pixel row and see if the pixel should be set
      beq charpix_col2  ;if the first bit is not a 1 go to the next pixel, otherwise, continue and print the pixel
      lda char_color	;load color stored above
      ;sta [vidpage], y ; write A register to address vidpage + y
      jsr WriteVidPageTILES
      jsr WriteVidPageVRAM
    charpix_col2:
      iny   ;shift pixel writing location one to the right
      lda char_from_charmap
      and #PIXEL_COL2
      beq charpix_col3
      lda char_color	;load color stored above
      ;sta [vidpage], y ; write A register to address vidpage + y
      jsr WriteVidPageTILES
      jsr WriteVidPageVRAM
    charpix_col3:
      iny
      ;lda charmap1, x
      lda char_from_charmap
      and #PIXEL_COL3
      beq charpix_col4
      lda char_color	;load color stored above
      ;sta [vidpage], y ; write A register to address vidpage + y
      jsr WriteVidPageTILES
      jsr WriteVidPageVRAM
    charpix_col4:
      iny
      lda char_from_charmap
      and #PIXEL_COL4
      beq charpix_col5
      lda char_color	;load color stored above
      ;sta [vidpage], y ; write A register to address vidpage + y
      jsr WriteVidPageTILES
      jsr WriteVidPageVRAM
    charpix_col5:
      iny
      lda char_from_charmap
      and #PIXEL_COL5
      beq charpix_rowdone
      lda char_color	;load color stored above
      ;sta [vidpage], y ; write A register to address vidpage + y
      jsr WriteVidPageTILES
      jsr WriteVidPageVRAM
    ;could expand support beyond 5 colums (up to 8, based on charmap)
    charpix_rowdone:
      jsr gfx_NextVGALineTILES   ;shift pixel writing location down one pixel
      jsr gfx_NextVGALineVRAM
      ldy char_y_offset_orig   ;back to first column

      ;check if we are through the 7 rows. if so, jump out. otherwise, start next row of font character.
      inc charPixelRowLoopCounter   ;inc row loop counter
      lda charPixelRowLoopCounter
      cmp #$08  ;see if we have made it through all 7 rows
      bne _nextRow  ;if we have not processed all 7 rows, branch to repeat. otherwise, go to next line

      ;no more rows to process in this character
      ldx #$00
      stx charPixelRowLoopCounter   ;row loop counter
      jmp NextChar  
NextChar:
  ;move the 'cursor' to the right by 6 pixels
  inc char_y_offset
  inc char_y_offset
  inc char_y_offset
  inc char_y_offset
  inc char_y_offset
  inc char_y_offset
  inc rows_remain   ;string char# tracker
  ldx rows_remain
  jmp PrintStringLoop
WriteVidPageVRAM:
  .setting "RegA16", false
  sep #$20            ;set acumulator to 8-bit
  sta [vidpageVRAM], y; write A register (color) to address vidpage + y
  .setting "RegA16", true
  rep #$20            ;set acumulator to 16-bit
  rts
WriteVidPageTILES:
  .setting "RegA16", false
  sep #$20            ;set acumulator to 8-bit
  sta [vidpageTILES], y; write A register (color) to address vidpage + y
  .setting "RegA16", true
  rep #$20            ;set acumulator to 16-bit
  rts
WriteVidPageBuffer:
  .setting "RegA16", false
  sep #$20            ;set acumulator to 8-bit
  sta [vidpage_buffer], y; write A register (color) to address vidpage + y
  .setting "RegA16", true
  rep #$20            ;set acumulator to 16-bit
  rts
PrintString:
  stx xtmp   ;store x
  ldx #$00
  stx rows_remain   ;printstring current char tracking
  ;falls into PrintStringLoop
    PrintStringLoop:
      lda message_to_process
      cmp #$00
        beq NoMessage
      cmp #$01
        beq SelectMessage1
      cmp #$02
        beq SelectMessage2
      cmp #$03
        beq SelectMessage3
      cmp #$04
        beq SelectMessage4
      cmp #$05
        beq SelectMessage5
      cmp #$06
        beq SelectMessage6
      cmp #$07
        beq SelectMessage7
      cmp #$08
        beq SelectMessage8
      cmp #$09
        beq SelectMessage9
      cmp #10
        beq SelectMessage10
      cmp #11
        beq SelectMessage11
      cmp #12
        beq SelectMessage12
      cmp #13
        beq SelectMessage13
      ;if nothing selected correctly at this point, assume message 1
      jmp SelectMessage1
PrintStringLoopCont:
  bne print_char_vga    ;where to go when there are chars to process
  ldx xtmp   ;set x back to orig value
  rts
gfx_DrawPixelTILES:
  pha ;a to stack
  phx ;x to stack
  phy ;y to stack

  ;store current 'cursor' location
  lda vidpageTILES + 2
  pha
  lda vidpageTILES
  pha
  phy
  tya

  lda fill_region_start_y
  sta jump_to_line_y
  jsr gfx_JumpToLineTILES

  ldy fill_region_start_x     ;horizontal pixel location, 0 to 319
  lda fill_region_color
    
  ;sta (vidpage), y; write A register (color) to address vidpage + y
  jsr WriteVidPageTILES
  
  ;put things back and return to sender
  ply
  pla
  sta vidpageTILES
  pla
  sta vidpageTILES + 2

  ;return items from stack
  ply ;stack to y
  plx ;stack to x
  pla ;stack to a

  rts
gfx_DrawPixelVRAM:
  pha ;a to stack
  phx ;x to stack
  phy ;y to stack

  ;store current 'cursor' location
  lda vidpageVRAM + 2
  pha
  lda vidpageVRAM
  pha
  phy
  tya

  lda fill_region_start_y
  sta jump_to_line_y
  jsr gfx_JumpToLineVRAM

  ldy fill_region_start_x     ;horizontal pixel location, 0 to 319
  lda fill_region_color
    
  ;sta (vidpage), y; write A register (color) to address vidpage + y
  jsr WriteVidPageVRAM

  ;put things back and return to sender
  ply
  pla
  sta vidpageVRAM
  pla
  sta vidpageVRAM + 2

  ;return items from stack
  ply ;stack to y
  plx ;stack to x
  pla ;stack to a

  rts
gfx_SetSpritesLocFromTiles:
  lda vidpageTILES + 2
  clc
  adc #$02
  sta vidpageSPRITES + 2

  lda vidpageTILES
  sta vidpageSPRITES
  rts
gfx_SetVRAMLocFromTiles:
  lda vidpageTILES + 2
  clc
  adc #$14
  sta vidpageVRAM + 2

  lda vidpageTILES
  sta vidpageVRAM
  rts
gfx_CopyVRAMToTile:
  //TO DO Implement copy vram to tile
  rts
gfx_CopyTileToVRAM:
  ;params:
    ;gfx_tile_size           = $00E0
    ;gfx_tile_start_x        = $00E2
    ;gfx_tile_start_y        = $00E4

  pha
  phx
  phy

  stz gfx_rows_processed
  lda gfx_tile_start_x
  sta gfx_pixelX
  lda gfx_tile_start_y
  sta gfx_pixelY
  lda #$000C
  sta gfx_convert_addr_bank
  jsr gfx_ConvertPixel_To_Address

  lda gfx_converted_addr+2
  and #$00FF
  sta gfx_source_bank
  
  stz gfx_rows_processed
  lda gfx_source_bank ;populated up higher
  clc
  adc #$14
  sta gfx_dest_bank
  ldx gfx_converted_addr
  txy ;put same value in y, so that source x is copied to dest y (but in different banks)

  ct_row:
    ;x = source addr, y = dest addr, a = length-1
    ;mvn destBank, sourceBank

    ;copy each row of the sprite
    //mvn $20, $0C    ;20 is top half of video frame, 0E is the first half of the frame buffer in extended RAM
    //mvn $21, $0D    ;21 is bottom half of video frame, 0F is the second half of the frame buffer in extended RAM

    lda gfx_source_bank
    cmp #$0C
    bne bank2
      lda #16 ;length (+1)  //TO DO This should be 15
      phb
      mvn $20, $0C
      plb
      bra bankCont
    bank2:
      lda #16 ;length (+1)
      phb
      mvn $21, $0D
      plb
    bankCont:

    txa
    clc
    adc #495  //next page    //512-16
    tax
    tay
    inc gfx_rows_processed
    lda gfx_rows_processed
    cmp #16
    bne ct_row

  ply
  plx
  pla
  rts
gfx_ConvertPixel_To_Address:
  ;params:
    ;gfx_converted_addr_bank ;ex: #$0020 for VRAM, #$0C for TILES
    ;gfx_pixelX
    ;gfx_pixelY
    ;result stored in gfx_converted_addr (4 bytes)

  ;TO DO safety code (keep in bounds)
  pha
  phx
  phy
    
  ;convert x,y position to gfx_converted_addr and gfx_converted_addr+2
  ;gfx_pixelX    0 to 319
  ;gfx_pixelY    0 to 239
  ;Only converts to LSB of full address. MSB isn't specified (e.g., 0C or 20) so can use with either
  ;Places result in gfx_converted_addr
  ;reset to default location of 0020:0000, or pixel 9,0
  ;lda #$0020
  lda gfx_convert_addr_bank ;ex: #$0020 for VRAM, #$0C for TILES
  sta gfx_converted_addr+2
  lda #$0000
  sta gfx_converted_addr

  ;for each y, add 512
  ldy gfx_pixelY
  cpy #0    ;if 0, don't add for y, since top row
  beq c_addX_step
  c_y_loop:
    clc
    lda gfx_converted_addr
    adc #512
    sta gfx_converted_addr
    lda gfx_converted_addr+2
    adc #0    ;no clc, to carry to next word
    sta gfx_converted_addr+2
    dey
    bne c_y_loop

  ;add X
  c_addX_step:
    clc
    lda gfx_converted_addr

    adc gfx_pixelX
    sta gfx_converted_addr
    lda gfx_converted_addr+2
    adc #0    ;no clc, to carry to next word
    sta gfx_converted_addr + 2

  ply
  plx
  pla
  rts
gfx_BackgroundDynamic:
    //a = fill color
  sta color
  pha ;a to stack
  phx ;x to stack
  phy ;y to stack

  //set vidpage back to start
  stz gfx_background_dynALL
  lda #$000C
  sta vidpageTILES + 2
  lda #$0000
  sta vidpageTILES
  
  ldy #$00                ;start counter - pixels in row
  ldx #$00                ;row number

  _gfx_bgd_loop:
    ;generate some colors
    tya
    lsr
    lsr
    lsr
    lsr
    clc
    adc gfx_background_dynALL
    sta gfx_background_dynALL

    ;sta [vidpage], y                                                               
    jsr WriteVidPageTILES
    iny     
    tya
    cmp #320        ;rollover        ;stop at 320 pixels in the row
    bne _gfx_bgd_loop                                                                   

    ;next row...
    clc
    lda vidpageTILES                                                                        
    adc #512    ;skip pixels 320 to 511, go to next row                                   
    sta vidpageTILES                                                                        
    ldy #0
    inx
    txa
    cmp #128    ;once 128 rows are processed, increment vidpage+2 to go to the next page
    bne _gfx_bgd_loop
    sta row
    ldx #0
    ldy #0
    clc
    lda vidpageTILES+2
    adc #$0001
    sta vidpageTILES+2   
    cmp #$0E        ;0C-0D are valid for video
    bne _gfx_bgd_loop

  ply
  plx
  pla
  rts
gfx_CacheSprite_16x16:
  ;params:

  ;Testing with Mario
  ;ROM start: 0x020800
  pha
  phx
  phy

  ;ldx #$0800
  ;ldy #$0000
  ldx gfx_ROM_source_address    //for now, assuming bank $02 - this var is the addr in the bank
  ldy gfx_ERAM_dest_address     //for now, assuming bank $0E (SPRITES) - this var is the addr in the bank

  stz gfx_rows_processed

  cs16_row:
    ;x = source addr, y = dest addr, a = length-1
    ;mvn destBank, sourceBank

    ;copy each row of the sprite
    //mvn $20, $0C    ;20 is top half of video frame, 0E is the first half of the frame buffer in extended RAM
    //mvn $21, $0D    ;21 is bottom half of video frame, 0F is the second half of the frame buffer in extended RAM

    lda #15 ;length (+1)  //TO DO This should be 15
    phb
    mvn $0E, $02    //ROM to ERAM
    plb

    ;txa
    ;clc
    ;adc #495  //next page    //512 minus 16
    ;tax
    
    tya 
    clc
    adc #496  //next page    //512 minus 16
    tay

    inc gfx_rows_processed
    lda gfx_rows_processed
    cmp #16
    bne cs16_row

  ply
  plx
  pla
  rts
gfx_CopySprite16ToVRAM:
  ;params:

  pha
  phx
  phy

  ldx gfx_ERAM_source_address    //for now, assuming bank $0E - this var is the addr in the bank
  ldy gfx_VRAM_dest_address     //for now, assuming bank $20 (VRAM) - this var is the addr in the bank

  stz gfx_rows_processed

  csv16_row:
    ;x = source addr, y = dest addr, a = length-1
    ;mvn destBank, sourceBank

    ;copy each row of the sprite
    //mvn $20, $0C    ;20 is top half of video frame, 0E is the first half of the frame buffer in extended RAM
    //mvn $21, $0D    ;21 is bottom half of video frame, 0F is the second half of the frame buffer in extended RAM

    lda #15 ;length (+1)  //TO DO This should be 15
    phb
    mvn $20, $0E    //ROM to ERAM
    plb

    txa
    clc
    adc #496  //next page    //512 minus 16
    tax
    
    tya 
    clc
    adc #496  //next page    //512 minus 16
    tay

    inc gfx_rows_processed
    lda gfx_rows_processed
    cmp #16
    bne csv16_row

  ply
  plx
  pla
  rts

;sprite page
  // gfx_DrawPointerSPRITES:
  //   ;put items on stack, so we can return them
  //   pha ;a to stack
  //   phx ;x to stack
  //   phy ;y to stack

  //   ;store current 'cursor' location
  //   lda vidpageSPRITES + 2
  //   pha
  //   lda vidpageSPRITES
  //   pha
  //   phy
  //   tya

  //   lda fill_region_start_y
  //   sta jump_to_line_y
  //   jsr gfx_JumpToLineSPRITES

  //   ldy fill_region_start_x     ;horizontal pixel location, 0 to 319
  //   //lda fill_region_color
  //   lda #%00011100

  //   ;sta (vidpage), y; write A register (color) to address vidpage + y
  //   jsr WriteVidPageSPRITES
  //   inx
  //   jsr WriteVidPageSPRITES
  //   iny
  //   jsr WriteVidPageSPRITES
  //   dex
  //   jsr WriteVidPageSPRITES
  //   dey

  //   lda #'B'
  //   jsr print_char_lcd

  //   //testing
  //   jsr gfx_SetVRAMLocFromTiles
  //   lda #%00011100
  //   jsr WriteVidPageVRAM
  //   inx
  //   jsr WriteVidPageVRAM
  //   iny
  //   jsr WriteVidPageVRAM
  //   dex
  //   jsr WriteVidPageVRAM
  //   dey

  //   ;put things back and return to sender
  //   ply
  //   pla
  //   sta vidpageSPRITES
  //   pla
  //   sta vidpageSPRITES + 2

  //   ;return items from stack
  //   ply ;stack to y
  //   plx ;stack to x
  //   pla ;stack to a
  //   rts
  // WriteVidPageSPRITES:
  //   sep #$20            ;set acumulator to 8-bit
  //   sta [vidpageSPRITES], y; write A register (color) to address vidpage + y
  //   rep #$20            ;set acumulator to 16-bit
  //   rts  
  // gfx_DrawPixelSPRITES:

  //   ;put items on stack, so we can return them
  //   pha ;a to stack
  //   phx ;x to stack
  //   phy ;y to stack

  //   ;store current 'cursor' location
  //   lda vidpageSPRITES + 2
  //   pha
  //   lda vidpageSPRITES
  //   pha
  //   phy
  //   tya

  //   lda fill_region_start_y
  //   sta jump_to_line_y
  //   jsr gfx_JumpToLineSPRITES
  //   jsr gfx_JumpToLineVRAM    //TO DO Needed?

  //   ldy fill_region_start_x     ;horizontal pixel location, 0 to 99
  //   lda fill_region_color
      
  //   ;sta (vidpage), y; write A register (color) to address vidpage + y
  //   jsr WriteVidPageSPRITES
  //   ;jsr WriteVidPageVRAM

  //   ;put things back and return to sender
  //   ply
  //   pla
  //   sta vidpageSPRITES
  //   pla
  //   sta vidpageSPRITES + 2

  //   ;return items from stack
  //   ply ;stack to y
  //   plx ;stack to x
  //   pla ;stack to a

  //   rts
  // gfx_FillScreenSPRITES:
  //     //a = fill color
  //   sta color
  //   pha ;a to stack
  //   phx ;x to stack
  //   phy ;y to stack

  //   //set vidpage back to start
  //   lda #$000E
  //   sta vidpageSPRITES + 2
  //   lda #$0000
  //   sta vidpageSPRITES
    
  //   ldy #$00                ;start counter - pixels in row
  //   ldx #$00                ;row number

  //   _gfx_fillscreensprites_loop:
  //     ;draw a line
  //     lda color           
  //     ;sta [vidpage], y                                                                        ;8031
  //     jsr WriteVidPageSPRITES
  //     iny     
  //     tya
  //     cmp #320        ;rollover        ;stop at 320 pixels in the row
  //     bne _gfx_fillscreensprites_loop                                                                          ;8038

  //     ;next row...
  //     clc
  //     lda vidpageSPRITES                                                                             ;803D
  //     adc #512    ;skip pixels 320 to 511, go to next row                                     ;803F
  //     sta vidpageSPRITES                                                                             ;8042
  //     ldy #0
  //     inx
  //     txa
  //     cmp #128    ;once 128 rows are processed, increment vidpage+2 to go to the next page
  //     bne _gfx_fillscreensprites_loop
  //     sta row
  //     ldx #0
  //     ldy #0
  //     clc
  //     lda vidpageSPRITES+2
  //     adc #$0001
  //     sta vidpageSPRITES+2   
  //     cmp #$10        ;0E-0F are valid for video, 10 is next I/O range, so done with video
  //     bne _gfx_fillscreensprites_loop

  //   ply ;stack to y
  //   plx ;stack to x
  //   pla ;stack to a
  // gfx_JumpToLineSPRITES:
  //     pha
  //     phx
  //     phy

  //     ;set vidpage back to start
  //     lda #$000E
  //     sta vidpageSPRITES + 2
  //     lda #$0000
  //     sta vidpageSPRITES

  //     ldx jump_to_line_y
  //     ;if jump_to_line_y is 0, we are done
  //     cpx #$00
  //     ;TO DO Verify jump_to_line_y does not exceed 239
  //     beq gfx_JumpToLineSpritesDone

  //     gfx_JumpToLineSpritesLoop:
  //     jsr gfx_NextVGALineSPRITES     ;there has to be a better way that to call this loop -- more of a direct calculation -- TBD
  //     dex
  //     bne gfx_JumpToLineSpritesLoop
      
  //     gfx_JumpToLineSpritesDone:

  //     ply
  //     plx
  //     pla
  //     rts
  // gfx_NextVGALineSPRITES:
  //     pha
  //     ;move the location for writing to the screen down one line
  //     clc
  //     lda vidpageSPRITES
  //     adc #512         ;add 512 to move to next row
  //     sta vidpageSPRITES    
  //     lda vidpageSPRITES + 2   ;do not clc... need the carry bit to roll to the second (high) byte
  //     adc #$00          ;add carry
  //     sta vidpageSPRITES + 2
  //     pla
  //     rts




;SelectMessge subroutines
    NoMessage:
      ;ldx $40   ;set x back to orig value
      ldx xtmp   ;set x back to orig value
      rts
    SelectMessage1:
      lda message1,x
      AND #$00FF      ; 16-bit adjustment to code
      jmp PrintStringLoopCont
    SelectMessage2:
      lda message2,x
      AND #$00FF      ; 16-bit adjustment to code
      jmp PrintStringLoopCont
    SelectMessage3:
      lda message3,x
      AND #$00FF      ; 16-bit adjustment to code
      jmp PrintStringLoopCont
    SelectMessage4:
      lda message4,x
      AND #$00FF      ; 16-bit adjustment to code
      jmp PrintStringLoopCont
    SelectMessage5:
      lda message5,x
      AND #$00FF      ; 16-bit adjustment to code
      jmp PrintStringLoopCont
    SelectMessage6:
      lda message6,x
      AND #$00FF      ; 16-bit adjustment to code
      jmp PrintStringLoopCont
    SelectMessage7:
      lda message7,x
      AND #$00FF      ; 16-bit adjustment to code
      jmp PrintStringLoopCont
    SelectMessage8:
      lda message8,x
      AND #$00FF      ; 16-bit adjustment to code
      jmp PrintStringLoopCont  
    SelectMessage9:
      lda message9,x
      AND #$00FF      ; 16-bit adjustment to code
      jmp PrintStringLoopCont  
    SelectMessage10:
      lda message10,x
      AND #$00FF      ; 16-bit adjustment to code
      jmp PrintStringLoopCont  
    SelectMessage11:
      lda message11,x
      AND #$00FF      ; 16-bit adjustment to code
      jmp PrintStringLoopCont  
    SelectMessage12:
      lda message12,x
      AND #$00FF      ; 16-bit adjustment to code
      jmp PrintStringLoopCont  
    SelectMessage13:
      lda message13,x
      AND #$00FF      ; 16-bit adjustment to code
      jmp PrintStringLoopCont ;Predefined messages
message1:   .asciiz "Red 0-7 (3 bits)"
message2:   .asciiz "Green 0-7 (3 bits)"
message3:   .asciiz "Blue 0-3 (2 bits)"
message4:   .asciiz "White (mix of bits per column above)"
message5:   .asciiz "RGB 0-255 (8 bits)"
message6:   .asciiz "Dynamically-generated Test Pattern"
message7:   .asciiz "320x240x1B (RRRGGGBB)  -- 5x7 fixed width font"
message8:   .asciiz "Welcome!"
message9:   .asciiz "Welcome to the VIA Test Utility."
message10:  .asciiz "Starting test..."
message11:  .asciiz "VIA Pass!"
message12:  .asciiz "VIA Fail!"
message13:  .asciiz "Time to play some music! Select songs 1 to 9.      Space to pause/resume.  (GUI coming later...)"
