rehsd/PC-65816/Assembly Code/July 9 2022/romData.asm

;Char pixel data
  ; Represent a 5x7 font (35 points/bits of data required)
  ; Store each character graphic as 8 bytes. This will waste 3 bits per byte (last three bits of seven bytes/rows) and one entire empty byte (row 8)
  ;                                          This extra room could be used to add support for font sizes up to 8x8 pixels per character.
  ; The first 5 bits of each byte will represent the pixels for a single row of the character. Last three bits of each row as zeros.
  ; Example - '8':
  ;  ***            = %01110000
  ; *   *           = %10001000
  ; *   *           = %10001000
  ;  ***            = %01110000
  ; *   *           = %10001000
  ; *   *           = %10001000
  ;  ***            = %01110000
  ; -empty-         = %00000000
  ; To reference, start at memory address for .org below.
.org $010000
charmap:   ;ASCII 0x20 to 0x7F
  ;Each character will consume 8 bytes of data (for the 8 potential rows of pixel data)
  ;char:SPACE ascii:0x20      charmap_location:0x00
      .byte %00000000
      .byte %00000000
      .byte %00000000
      .byte %00000000
      .byte %00000000
      .byte %00000000
      .byte %00000000
      .byte %00000000
  ;char:!     ascii:0x21      charmap_location:0x08 (increase by 8 bits/rows per char)
      .byte %00100000
      .byte %00100000
      .byte %00100000
      .byte %00100000
      .byte %00100000
      .byte %00000000
      .byte %00100000
      .byte %00000000
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
.byte %00000000, %00000000   ;HLT (3)
.byte %00000000, %00000000   ;HLT (3)
.byte %00000000, %00000000   ;HLT (3)
.byte %00000000, %00000000   ;HLT (4)
.byte %00000000, %00000000   ;HLT (4)
.byte %00000000, %00000000   ;HLT (4)
.byte %00000000, %00000000   ;HLT (4)
.byte %00000000, %00000000   ;HLT (5)
.byte %00000000, %00000000   ;HLT (5)
.byte %00000000, %00000000   ;HLT (5)
.byte %00000000, %00000000   ;HLT (5)
.byte %00000000, %00000000   ;HLT (6)
.byte %00000000, %00000000   ;HLT (6)
.byte %00000000, %00000000   ;HLT (6)
.byte %00000000, %00000000   ;HLT (6)
.byte %00000000, %00000000   ;HLT (7)
.byte %00000000, %00000000   ;HLT (7)
.byte %00000000, %00000000   ;HLT (7)
.byte %00000000, %00000000   ;HLT (7)
