rehsd/PC-65816/(commit log)

2022-03-25 Initial PCB designs
    As initially ordered. No fixes applied.
2022-04-17 Version 13 of old 6502 code and music editor
    Includes FPGA video out, audio, and SPI.
2022-04-19 Create Debug 65816.ino
    Arduino Mega code to monitor bus
2022-05-23 Updated dual-port RAM out pin order.
